eloyf26/PX4-Autopilot/hardware/cuav_v6x_fmum/photos/fmum_bottom_mcu_side.jpg

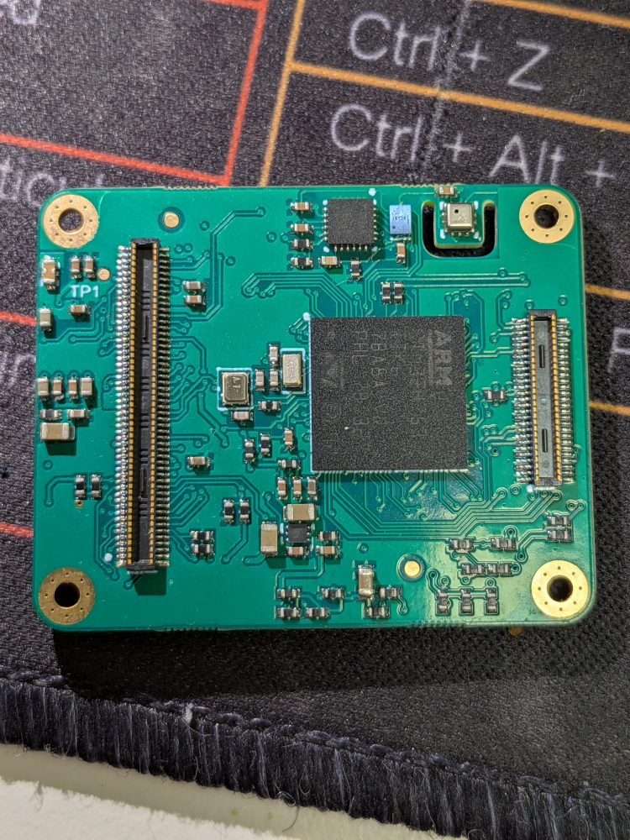
hardware/cuav_v6x_fmum/photos/fmum_bottom_mcu_side.jpg
