eloyf26/PX4-Autopilot/hardware/cuav_v6x_fmum/photos/imu_bottom_flex_side.jpg

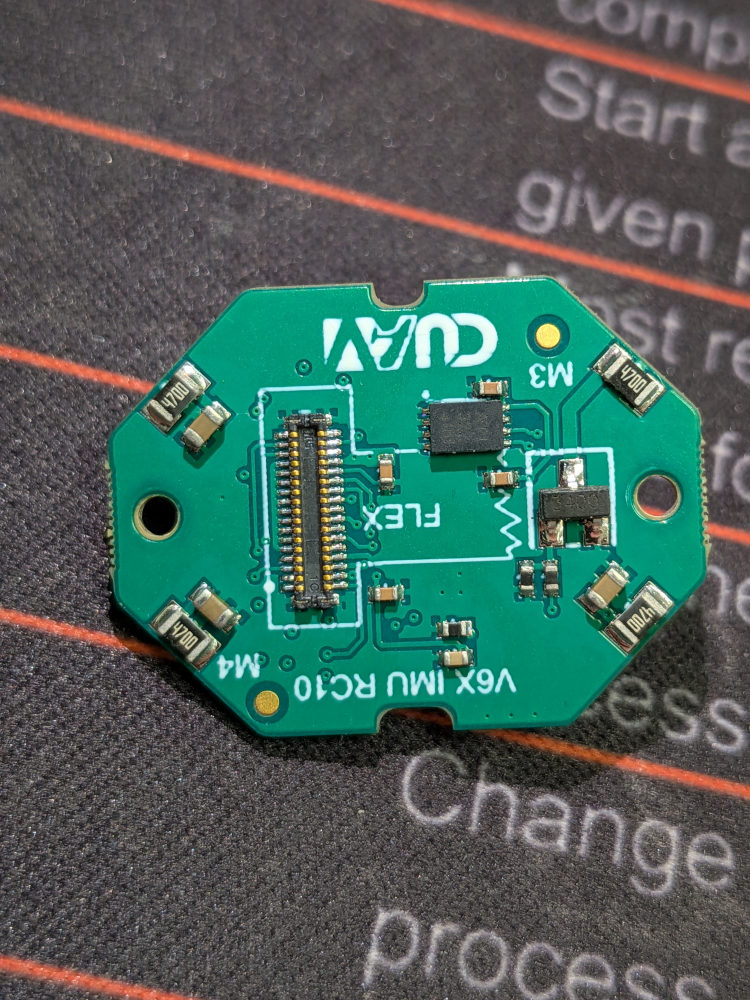
hardware/cuav_v6x_fmum/photos/imu_bottom_flex_side.jpg
