eloyf26/PX4-Autopilot/hardware/cuav_v6x_fmum/cuav_v6x_fmum_schematic.html

board identification · reverse-engineered schematic

# CUAV V6X FMUM — the plug-in brain of a Pixhawk V6X autopilot

Not official. CUAV publishes no schematic of the V6X modules and the full Pixhawk FMUv6X reference schematics are Dronecode-member-only. This is an independent reconstruction: connectivity from the PX4 firmware that runs on this hardware, connector pinouts from the public Pixhawk standards, part identification from the photos.

The board in your photos is the FMU core module of the CUAV Pixhawk V6X flight controller: an STM32H7 processor, memory, one IMU and one barometer on a 36 × 31 mm card that plugs into a base board through the Pixhawk Autopilot Bus. Below: what every visible part is, how the module works, and six schematic sheets rebuilt from the PX4 firmware that runs on it and the two public Pixhawk standards it implements.

silkscreen

V6X_FMUM RC11 · 07-17/23

maker

CUAV (Guangzhou)

standard

Pixhawk FMUv6X · PAB (DS-010 / DS-012)

processor

STM32H743IIK6, 480 MHz M7

firmware target

px4_fmu-v6x · HW type V6X001

size

36.0 × 31.4 mm · 4 × M2 ground holes

## 1 · What you are looking at

Bottom of the module (faces the base board): processor, both bus connectors, IMU 3, barometer 2, crystals, regulators.

U1 STM32H7 BGAX1 · 100-pin PABX2 · 50-pin PABICM-20649 IMU3ICP-20100 baro, in slotY1 16 MHz / Y2 32 kHz3.3 V step-downsensor LDOs + ID resistors

A Bottom of the module (faces the base board): processor, both bus connectors, IMU 3, barometer 2, crystals, regulators.

Top of the module (visible when installed): IMU flex connector, microSD, FRAM, secure element, RTC cell, LEDs, trace pads.

J3 FLEX → IMU boardJ4 microSDFM25V02A FRAMSE050 (likely)B1 RTC cellD1-D3 LEDsJ1 TRACE padsBT0 = BOOT0

B Top of the module (visible when installed): IMU flex connector, microSD, FRAM, secure element, RTC cell, LEDs, trace pads.

seen on the photo | what it is | confidence
10 × 10 mm BGA, marked ARM / STM32H7…IIK6 | U1, STM32H743IIK6 (PX4 configures the H753 sibling). UFBGA176+25. | HIGH
100-pin + 50-pin 0.4 mm connectors | X1 / X2 Hirose DF40 — the Pixhawk Autopilot Bus. 3 mm stack to the base board. | HIGH
3 × 3 mm QFN, top centre of MCU side | ICM-20649 six-axis IMU #3 on SPI1 (the one hard-mounted IMU). | HIGH
2 mm metal-lid part with a port hole, in a U-shaped routed slot | ICP-20100 barometer #2 on I2C2. The slot decouples it from board flex. | HIGH
Two small metal cans left of the BGA | Y1 16 MHz (HSE) and Y2 32.768 kHz (RTC) crystals — PX4 board.h confirms both frequencies. | HIGH
QFN + big inductor + capacitors, bottom centre | U_REG, the 5 V → 3.3 V step-down for the MCU rail. | MEDIUM
SOT-23-5 ICs with 0402 capacitor clusters, right edge | the four switched sensor LDOs and decoupling. | MEDIUM
1.5 mm blue part marked IY2K | small passive or IC (ESD array / tiny LDO). Not resolvable from the photo. | LOW
34-pin connector labelled FLEX | J3 to the separate vibration-isolated IMU board; two of the three IMUs and the compass are there. | HIGH
SOIC-8 at top | FM25V02A 256 kbit FRAM — PX4 parameter storage; byte-writable, no wear. | HIGH
3 × 3 mm QFN marked S50 08 07 | most likely NXP SE050 secure element (I2C4 0x48, in the reference sensor set). | MEDIUM
Round metal can marked L03 | B1 RTC backup cell; exported to the base as V_RTC_BAT (X1-29). | HIGH
Three 0603 LEDs, 8+2 unpopulated pads, BT0 pad | D1-D3 status LEDs · J1 ETM trace footprint · BOOT0 for the ST DFU bootloader. | HIGH

Where the confidence comes from. The module runs PX4's px4_fmu-v6x target and identifies itself as hardware type V6X001 ("CUAV sensor set rev 1") through a resistor ladder. The PX4 board files for that target hard-code every MCU pin, SPI chip-select, data-ready line, I²C address and power-enable, so the connectivity below is read from the firmware rather than guessed from traces. Connector pinouts come from the Pixhawk DS-010 and DS-012 standards. Only regulator part numbers, passive values and two small ICs are inferred.

### The second board: V6X IMU RC10

The octagonal board on the other end of the FLEX cable is CUAV's IMU board (silkscreen V6X IMU RC10, 2022-09-20). It sits in an elastomer isolation mount — the two half-round notches and the four ground pads M1-M4 are the mount interface — so the inertial sensors ride on a damped mass while the processor board is bolted rigidly to the base. It has no regulators: every rail arrives over the flex.

IMU board, sensor side: BMI088, ICM-42688-P, the RM3100 compass as controller plus three coils, barometer #1.

BMI088 (IMU 1)ICM-42688-P (IMU 2)PNI MagI2C (RM3100)Sen-XY-f coil XSen-XY-f coil YSen-Z-f coilICP-20100 baro #1flight arrow

C IMU board, sensor side: BMI088, ICM-42688-P, the RM3100 compass as controller plus three coils, barometer #1.

IMU board, flex side: mating 34-pin connector, calibration EEPROM, four 470 Ω heater resistors and their MOSFET.

FLEX (mates FMUM J3)24LC64 cal EEPROMMOSFET '3400'470 Ω heater ×4

D IMU board, flex side: mating 34-pin connector, calibration EEPROM, four 470 Ω heater resistors and their MOSFET.

seen on the photo | what it is | confidence
Rectangular LGA, top left (sensor side) | Bosch BMI088 accel + gyro — IMU 1 on SPI3, power domain 3. | HIGH
Small LGA below it | TDK ICM-42688-P — IMU 2 on SPI2, domain 2. | HIGH
4 × 4 mm QFN, centre right | PNI MagI2C, the controller of the RM3100 compass — I2C4 address 0x20. | HIGH
Two flat black bars marked PNI, one horizontal one vertical | PNI Sen-XY-f sense coils for the X and Y axes, mounted at 90°. | HIGH
Black cube below the QFN | PNI Sen-Z-f coil for the vertical axis. | HIGH
Metal lid with port hole, bottom left | TDK ICP-20100 barometer #1 — I2C4 address 0x64 (AD0 high). | HIGH
34-pin 0.4 mm connector labelled FLEX (flex side) | Mating half of the FMUM's J3; a short FPC jumper links the two boards. | HIGH
SOIC-8 (flex side) | 24LC64 calibration EEPROM — I2C4 0x50; PX4 stores calibration, revision and ID here. | HIGH
Four large resistors marked 4700 | 470 Ω heater resistors in parallel: 117 Ω across 5 V, about 0.21 W under the IMUs. | HIGH
SOT-23 marked 3400 beside a resistor silkscreen symbol | N-channel MOSFET (AO3400 class): low-side switch for the heater, driven by the HEATER line (PB10). | HIGH

## 2 · How the module works

Three boards, one system. Only 5 V and 3.3 V logic cross the connectors; everything that touches the outside world (transceivers, power switching, ESD) stays on the base board, which is what makes the module small and reusable across vendors.

#### base board (not this PCB)

Power path selector2 bricks + USB → VDD_5V_IN, 4 pins on X1

JST-GH portsTELEM1-3, GPS1/2, UART4, CAN1/2, USB, PWM, ADIO, debug

STM32F103 PX4IO8 more PWM + RC in, talks to U1 on USART6

LAN8742A Ethernet PHYRMII over X2

Base ID ladder + 24LC64 EEPROMHW_VER_SENSE, I2C3

X1 100 p
X2 50 p
⇄

#### FMU module — this board

U1 STM32H743IIK6480 MHz M7 · 2 MB flash · 1 MB RAM

U_REG 5 V → 3.3 V step-downFMU_VDD_3V3, also exported on X1-84/86

U_LDO1…4 switched 3.3 Vone per sensor domain · EN + ADC sense each

FM25V02A FRAM · SPI5parameters

microSD · SDMMC2logs · power-cycled by PC13

ICM-20649 · SPI1IMU 3, domain 1

ICP-20100 · I2C2baro 2, in stress-relief slot

SE050 · I2C4secure element (likely)

B1 RTC cell · Y1 16 MHz · Y2 32 kHztime-keeping

HW-ID ladder 24.9k/442kmodule ID 1 = CUAV sensor set rev 1

J3 34 p
⇄

#### IMU board (via J3 flex)

BMI088 · SPI3IMU 1, domain 3

ICM-42688-P · SPI2IMU 2, domain 2

RM3100 · I2C4 0x20compass, domain 4

ICP-20100 · I2C4 0x64baro 1, domain 4

24LC64 · I2C4 0x50calibration EEPROM

Heater resistors + MOSFETHEATER from PB10, VDD_5V_IN

- One supply in, everything generated locally. VDD_5V_IN enters on four X1 pins. A step-down makes FMU_VDD_3V3 for the MCU and memories; that rail is also exported back to the base (X1-84/86).
- Four independent sensor power domains. Each IMU or compass group has its own LDO with an MCU-controlled enable and a 1:2 divider read by the ADC, so PX4 can power-cycle one misbehaving domain and watch every rail.
- One IMU per SPI bus (SPI1/2/3), each with a hardware data-ready interrupt; a hung device cannot stall the others. I2C4 is the internal sensor bus, I2C1-3 go to the base for GPS pucks and power monitors.
- Storage: FRAM for parameters (byte-writable, no wear), microSD for logs, battery-backed RTC and SRAM.
- Self-identification. At boot PG0 powers two resistor ladders; ADC3 reads them on PH4 (module ID) and PH3 (base ID, via X1-27). PX4 then starts exactly the right drivers and axis rotations for this sensor set.

### Sensor set of this revision

role | part | bus | CS / addr | DRDY | power domain | location
IMU 1 | Bosch BMI088 accel + gyro | SPI3 | PI4 (accel) / PI8 (gyro) | PI7 | SENSORS3 | IMU board (J3)
IMU 2 | TDK ICM-42688-P | SPI2 | PH5 | PA10 | SENSORS2 | IMU board (J3)
IMU 3 | TDK ICM-20649 | SPI1 | PI9 | PF2 | SENSORS1 | this module
Compass | PNI RM3100 | I2C4 | 0x20 | — | SENSORS4 | IMU board (J3)
Baro 1 | TDK ICP-20100 | I2C4 | 0x64 | — | SENSORS4 | IMU board (J3)
Baro 2 | TDK ICP-20100 | I2C2 | 0x63 | PG5 | SENSORS2 | this module
Cal. EEPROM | 24LC64 | I2C4 | 0x50 | — | SENSORS4 | IMU board (J3)
Parameters | FM25V02A FRAM 256 kbit | SPI5 | PG7 | — | FMU 3V3 | this module
Secure element | NXP SE050 (likely) | I2C4 | 0x48 | — | FMU 3V3 | this module

## 3 · Schematic sheets

KiCad: two projects with PCBs. The same data is generated as two KiCad 8 projects in hardware/cuav_v6x_fmum/kicad/ on branch claude/unknown-component-schematics-mdgis0: fmum/cuav_v6x_fmum.kicad_pro (FMU module, 4 schematic sheets + a 36 × 31.4 mm 6-layer PCB) and imu/cuav_v6x_imu.kicad_pro (IMU board, schematic + 25 × 18 mm 4-layer PCB). Both boards carry the real outline, holes, connector positions from the Pixhawk standard, datasheet-verified footprints with every pad net-assigned, and photo-derived component placement. They are unrouted: the original inner-layer copper cannot be recovered from photos. The README lists exactly which footprint geometries were approximated.

Net names follow the Pixhawk standards, so they line up with the published base-board reference schematics. Blue = MCU pin, green = signal net, copper = power rail, grey = ground.

### Sheet 1 · U1 microcontroller

open full size ↗

Every used pin of the STM32H7: peripheral function inside the symbol, net name outside, and where the net goes in the margin. Pins not shown are unconnected on the module.

### Sheet 2 · Core peripherals

open full size ↗

FRAM, secure element, microSD with its power switch, both crystals, RTC cell, status LEDs, USB lines, the hardware-ID ladder and the reset / boot / trace provisions.

### Sheet 3 · Power domains and on-module sensors

open full size ↗

The 3.3 V step-down, the four switched sensor LDOs with their ADC dividers, the on-board ICM-20649 and ICP-20100, the heater control line and the I²C pull-ups.

### Sheet 4 · X1 — Pixhawk Autopilot Bus, 100 pins

open full size ↗

Pin-by-pin with the MCU pin that drives each signal. Odd pins on one row, even on the other.

### Sheet 5 · X2 — Pixhawk Autopilot Bus, 50 pins

open full size ↗

RMII Ethernet to the PHY on the base, the external SPI6 payload bus, and the pins the standard reserves but an FMUv6X module leaves unconnected.

### Sheet 6 · J3 — IMU flex connector, 34 pins

open full size ↗

Two SPI buses, I2C4, three switched 3.3 V rails, raw 5 V for the heater and the heater control line, with a ground between every signal group.

### Sheet 7 · IMU board (V6X IMU RC10)

open full size ↗

Everything on the vibration-isolated board: the mating flex connector, BMI088, ICM-42688-P, the RM3100 controller with its three coils, barometer #1, the calibration EEPROM and the heater with its MOSFET.

## 4 · Pin tables

### U1 pin map (as configured by PX4 for this module)

U1 pin | function | net | goes to
PA0 | ADC1_INP16 | SCALED_VDD_3V3_SENSORS1 | R-divider on VDD_3V3_SENSORS1
PA1 | ETH_REF_CLK | ETH_REF_CLK | X2-3
PA2 | ETH_MDIO | ETH_MDIO | X2-2
PA3 | USART2_RX | USART2_RX_TELEM3 | X1-42
PA4 | ADC12_INP18 | SCALED_VDD_3V3_SENSORS2 | R-divider on VDD_3V3_SENSORS2
PA5 | SPI1_SCK | SPI1_SCK_SENSOR1 | U_IMU3 ICM-20649 SCLK
PA6 | SPI6_MISO | SPI6_MISO_EXTERNAL1 | X2-31
PA7 | ETH_CRS_DV | ETH_CRS_DV | X2-7
PA8 | I2C3_SCL | I2C3_SCL_BASE | X1-10
PA9 | OTG_FS_VBUS | VBUS_SENSE | X1-80
PA10 | GPIO in (EXTI) | SPI2_DRDY2_IMU2_INT2 | J3-31
PA11 | OTG_FS_DM | USB_D_N | X1-78
PA12 | OTG_FS_DP | USB_D_P | X1-76
PA13 | SWDIO | FMU_SWDIO | X1-75
PA14 | SWCLK | FMU_SWCLK | X1-77
PA15 | GPIO out | SPI6_nCS2_EXTERNAL1 | X2-43
PB0 | ADC12_INP9 | SCALED_VDD_3V3_SENSORS3 | R-divider on VDD_3V3_SENSORS3
PB1 | ADC12_INP5 | SCALED_V5 | R-divider on VDD_5V_IN
PB2 | SPI3_MOSI | SPI3_MOSI_SENSOR3 | J3-14
PB3 | SPI6_SCK / SWO | SPI6_SCK_EXTERNAL1 | X2-35
PB4 | SDMMC2_D3 | SD_D3 | J4 microSD DAT3
PB5 | SPI1_MOSI | SPI1_MOSI_SENSOR1 | U_IMU3 ICM-20649 SDI
PB6 | USART1_TX | USART1_TX_GPS1 | X1-36
PB7 | USART1_RX | USART1_RX_GPS1 | X1-34
PB8 | I2C1_SCL | I2C1_SCL_BASE | X1-18
PB9 | I2C1_SDA | I2C1_SDA_BASE | X1-16
PB10 | GPIO out (TIM2_CH3) | HEATER | J3-30
PB11 | ETH_TX_EN | ETH_TX_EN | X2-27
PB12 | FDCAN2_RX | CAN2_RX | X1-59
PB13 | FDCAN2_TX | CAN2_TX | X1-57
PB14 | SDMMC2_D0 | SD_D0 | J4 microSD DAT0
PB15 | SDMMC2_D1 | SD_D1 | J4 microSD DAT1
PC0 | GPIO in (EXTI) | NFC_GPIO | X2-48
PC1 | ETH_MDC | ETH_MDC | X2-4
PC2 | ADC3_INP12 (PC2_C) | ADC1_6V6 | X1-90
PC3 | ADC3_INP13 (PC3_C) | ADC1_3V3 | X1-92
PC4 | ETH_RXD0 | ETH_RXD0 | X2-11
PC5 | ETH_RXD1 | ETH_RXD1 | X2-15
PC6 | USART6_TX | USART6_TX_TO_IO | X1-72
PC7 | USART6_RX | USART6_RX_FROM_IO_RC | X1-70
PC8 | UART5_RTS | UART5_RTS_TELEM2 | X1-58
PC9 | UART5_CTS | UART5_CTS_TELEM2 | X1-60
PC10 | SPI3_SCK | SPI3_SCK_SENSOR3 | J3-10
PC11 | SPI3_MISO | SPI3_MISO_SENSOR3 | J3-12
PC12 | UART5_TX | UART5_TX_TELEM2 | X1-52
PC13 | GPIO out | VDD_3V3_SD_CARD_EN | Q_SD load switch EN
PC14 | OSC32_IN | 32KHZ_IN | Y2 32.768 kHz
PC15 | OSC32_OUT | 32KHZ_OUT | Y2 32.768 kHz
PD0 | FDCAN1_RX | CAN1_RX | X1-65
PD1 | FDCAN1_TX | CAN1_TX | X1-63
PD2 | UART5_RX | UART5_RX_TELEM2 | X1-54
PD3 | USART2_CTS | USART2_CTS_TELEM3 | X1-48
PD4 | USART2_RTS | USART2_RTS_TELEM3 | X1-46
PD5 | USART2_TX | USART2_TX_TELEM3 | X1-40
PD6 | SDMMC2_CK | SD_CLK | J4 microSD CLK
PD7 | SDMMC2_CMD | SD_CMD | J4 microSD CMD
PD8 | USART3_TX | USART3_TX_DEBUG | X1-69
PD9 | USART3_RX | USART3_RX_DEBUG | X1-71
PD10 | GPIO out | FMU_nSAFETY_SWITCH_LED_OUT | X1-23
PD11 | GPIO in | SPI6_DRDY1_EXTERNAL1 | X2-47
PD12 | GPIO in | SPI6_DRDY2_EXTERNAL1 | X2-45
PD13 | TIM4_CH2 | FMU_CH5 | X1-7
PD14 | TIM4_CH3 | FMU_CH6 | X1-5
PD15 | GPIO in (spare) | PD15_SPARE | NC
PE0 | UART8_RX | UART8_RX_GPS2 | X1-30
PE1 | UART8_TX | UART8_TX_GPS2 | X1-28
PE2 | TRACECLK | TRACECLK | J1 TRACE-1
PE3 | GPIO od (TRACED0) | nLED_RED | D1 red LED cathode (+ J1 TRACE-3)
PE4 | GPIO od (TRACED1) | nLED_GREEN | D2 green LED cathode (+ J1 TRACE-5)
PE5 | GPIO od (TRACED2) | nLED_BLUE | D3 blue LED cathode (+ J1 TRACE-7)
PE6 | GPIO (TRACED3) | nARMED | X1-85 (+ J1 TRACE-8)
PE7 | GPIO out | VDD_3V3_SENSORS3_EN | U_LDO3 EN
PE8 | UART7_TX | UART7_TX_TELEM1 | X1-64
PE9 | GPIO out | SPIX_SYNC | X2-49
PE10 | UART7_CTS | UART7_CTS_TELEM1 | X1-24
PE11 | TIM1_CH2 (capture) | FMU_CAP1 | X1-97
PE15 | GPIO in | VDD_5V_PERIPH_nOC | X1-37
PF0 | I2C2_SDA | I2C2_SDA_BASE | X1-12 (+ U_BARO2 ICP-20100 SDA)
PF1 | I2C2_SCL | I2C2_SCL_BASE | X1-14 (+ U_BARO2 ICP-20100 SCL)
PF2 | GPIO in (EXTI) | SPI1_DRDY1_IMU3_INT1 | U_IMU3 ICM-20649 INT1
PF4 | GPIO out | VDD_3V3_SENSORS2_EN | U_LDO2 EN
PF5 | GPIO in (pull-up) | FMU_SAFETY_SWITCH_IN | X1-21
PF6 | UART7_RX | UART7_RX_TELEM1 | X1-66
PF7 | SPI5_SCK | SPI5_SCK_FRAM | U_FRAM FM25V02A SCK
PF8 | UART7_RTS | UART7_RTS_TELEM1 | X1-22
PF9 | TIM14_CH1 | BUZZER_1 | X1-4
PF10 | GPIO out | SPI6_nRESET_EXTERNAL1 | X2-39
PF11 | SPI5_MOSI | SPI5_MOSI_FRAM | U_FRAM FM25V02A SI
PF12 | ADC1_INP6 | SCALED_VDD_3V3_SENSORS4 | R-divider on VDD_3V3_SENSORS4
PF13 | GPIO in | VDD_5V_HIPOWER_nOC | X1-83
PF14 | I2C4_SCL | I2C4_SCL_FMU | J3-7 (+ U_SE SE050 SCL)
PF15 | I2C4_SDA | I2C4_SDA_FMU | J3-5 (+ U_SE SE050 SDA)
PG0 | GPIO out | HW_VER_REV_DRIVE | X1-25 (+ top of FMUM ID ladder)
PG1 | GPIO in (pull-up) | nPOWER_IN_A | X1-89
PG2 | GPIO in (pull-up) | nPOWER_IN_B | X1-91
PG3 | GPIO in (pull-up) | nPOWER_IN_C | X1-93
PG4 | GPIO out | VDD_5V_PERIPH_nEN | X1-35
PG5 | GPIO in (EXTI) | I2C2_DRDY1_BARO2 | U_BARO2 ICP-20100 INT (optional)
PG6 | GPIO in (pull-up) | PG6 | X2-44
PG7 | GPIO out | SPI5_nCS1_FRAM | U_FRAM FM25V02A nCS
PG8 | GPIO out | VDD_3V3_SENSORS4_EN | U_LDO4 EN
PG9 | SPI1_MISO | SPI1_MISO_SENSOR1 | U_IMU3 ICM-20649 SDO
PG10 | GPIO out | VDD_5V_HIPOWER_nEN | X1-81
PG11 | SDMMC2_D2 | SD_D2 | J4 microSD DAT2
PG12 | ETH_TXD1 | ETH_TXD1 | X2-23
PG13 | ETH_TXD0 | ETH_TXD0 | X2-19
PG14 | SPI6_MOSI | SPI6_MOSI_EXTERNAL1 | X2-33
PG15 | GPIO out | ETH_POWER_EN | X2-6
PH0 | OSC_IN | 16MHZ_IN | Y1 16 MHz
PH1 | OSC_OUT | 16MHZ_OUT | Y1 16 MHz
PH2 | GPIO out | VDD_3V3_SPEKTRUM_POWER_EN | X1-33
PH3 | ADC3_INP14 | HW_VER_SENSE | X1-27 (base-board ID ladder)
PH4 | ADC3_INP15 | HW_REV_SENSE | FMUM ID ladder (R_up 24.9k / R_dn 442k = ID 1)
PH5 | GPIO out | SPI2_nCS1_IMU2 | J3-33
PH6 | TIM12_CH1 | FMU_CH7 | X1-3
PH7 | SPI5_MISO | SPI5_MISO_FRAM | U_FRAM FM25V02A SO
PH8 | I2C3_SDA | I2C3_SDA_BASE | X1-8
PH9 | TIM12_CH2 | FMU_CH8 | X1-1
PH10 | TIM5_CH1 | FMU_CH4 | X1-11
PH11 | TIM5_CH2 | FMU_CH3 | X1-13 (+ X2-50 'PH11')
PH12 | TIM5_CH3 | FMU_CH2 | X1-15
PH13 | UART4_TX | UART4_TX | X1-98
PH14 | UART4_RX | UART4_RX | X1-96
PI0 | TIM5_CH4 | FMU_CH1 | X1-17
PI1 | SPI2_SCK | SPI2_SCK_SENSOR2 | J3-20
PI2 | SPI2_MISO | SPI2_MISO_SENSOR2 | J3-22
PI3 | SPI2_MOSI | SPI2_MOSI_SENSOR2 | J3-24
PI4 | GPIO out | SPI3_nCS1_BMI088_ACCEL | J3-2
PI5 | TIM8_CH1 (capture) | FMU_PPM_INPUT | X1-39
PI6 | GPIO in | SPI3_DRDY1_BMI088_INT1 | NC (not wired on flex for sensor set 1)
PI7 | GPIO in (EXTI) | SPI3_DRDY2_BMI088_INT3_GYRO | J3-3
PI8 | GPIO out | SPI3_nCS2_BMI088_GYRO | J3-4
PI9 | GPIO out | SPI1_nCS1_IMU3 | U_IMU3 ICM-20649 nCS
PI10 | GPIO out | SPI6_nCS1_EXTERNAL1 | X2-41
PI11 | GPIO out | VDD_3V3_SENSORS1_EN | U_LDO1 EN
NRST | reset | FMU_nRST | X1-87 (+ 100 nF to GND)
BOOT0 | boot select | BOOT0 | test pad 'BT0', 10k pull-down
VBAT | backup supply | V_RTC_BAT | B1 backup cell + X1-29
PDR_ON | power-down reset | FMU_VDD_3V3 | tie to VDD
VDD/VDDA/VDDUSB/VDDLDO | supply | FMU_VDD_3V3 | 100 nF per pin + 4.7 uF bulk
VCAP1/VCAP2 | core LDO caps | VCAP | 2.2 uF each to GND
VREF+ | ADC reference | FMU_VDD_3V3 | via ferrite/1 uF

### X1 — 100-pin bus

pin | net | U1 | pin | net | U1
1 | FMU_CH8 | PH9 | 2 | GND
3 | FMU_CH7 | PH6 | 4 | BUZZER_1 | PF9
5 | FMU_CH6 | PD14 | 6 | GND
7 | FMU_CH5 | PD13 | 8 | I2C3_SDA_BASE | PH8
9 | GND | | 10 | I2C3_SCL_BASE | PA8
11 | FMU_CH4 | PH10 | 12 | I2C2_SDA_BASE | PF0
13 | FMU_CH3 | PH11 | 14 | I2C2_SCL_BASE | PF1
15 | FMU_CH2 | PH12 | 16 | I2C1_SDA_BASE | PB9
17 | FMU_CH1 | PI0 | 18 | I2C1_SCL_BASE | PB8
19 | GND | | 20 | GND
21 | FMU_SAFETY_SWITCH_IN | PF5 | 22 | UART7_RTS_TELEM1 | PF8
23 | FMU_nSAFETY_SWITCH_LED_OUT | PD10 | 24 | UART7_CTS_TELEM1 | PE10
25 | HW_VER_REV_DRIVE | PG0 | 26 | GND
27 | HW_VER_SENSE | PH3 | 28 | UART8_TX_GPS2 | PE1
29 | V_RTC_BAT | | 30 | UART8_RX_GPS2 | PE0
31 | GND | | 32 | GND
33 | VDD_3V3_SPEKTRUM_POWER_EN | PH2 | 34 | USART1_RX_GPS1 | PB7
35 | VDD_5V_PERIPH_nEN | PG4 | 36 | USART1_TX_GPS1 | PB6
37 | VDD_5V_PERIPH_nOC | PE15 | 38 | GND
39 | FMU_PPM_INPUT | PI5 | 40 | USART2_TX_TELEM3 | PD5
41 | GND | | 42 | USART2_RX_TELEM3 | PA3
43 | GND | | 44 | GND
45 | GND | | 46 | USART2_RTS_TELEM3 | PD4
47 | GND | | 48 | USART2_CTS_TELEM3 | PD3
49 | VDD_5V_IN | | 50 | GND
51 | VDD_5V_IN | | 52 | UART5_TX_TELEM2 | PC12
53 | VDD_5V_IN | | 54 | UART5_RX_TELEM2 | PD2
55 | VDD_5V_IN | | 56 | GND
57 | CAN2_TX | PB13 | 58 | UART5_RTS_TELEM2 | PC8
59 | CAN2_RX | PB12 | 60 | UART5_CTS_TELEM2 | PC9
61 | GND | | 62 | GND
63 | CAN1_TX | PD1 | 64 | UART7_TX_TELEM1 | PE8
65 | CAN1_RX | PD0 | 66 | UART7_RX_TELEM1 | PF6
67 | GND | | 68 | GND
69 | USART3_TX_DEBUG | PD8 | 70 | USART6_RX_FROM_IO_RC | PC7
71 | USART3_RX_DEBUG | PD9 | 72 | USART6_TX_TO_IO | PC6
73 | GND | | 74 | GND
75 | FMU_SWDIO | PA13 | 76 | USB_D_P | PA12
77 | FMU_SWCLK | PA14 | 78 | USB_D_N | PA11
79 | GND | | 80 | VBUS_SENSE
81 | VDD_5V_HIPOWER_nEN | PG10 | 82 | GND
83 | VDD_5V_HIPOWER_nOC | PF13 | 84 | FMU_VDD_3V3
85 | nARMED | PE6 | 86 | FMU_VDD_3V3
87 | FMU_nRST | NRST | 88 | GND
89 | nPOWER_IN_A | PG1 | 90 | ADC1_6V6 | PC2
91 | nPOWER_IN_B | PG2 | 92 | ADC1_3V3 | PC3
93 | nPOWER_IN_C | PG3 | 94 | GND
95 | GND | | 96 | UART4_RX | PH14
97 | FMU_CAP1 | PE11 | 98 | UART4_TX | PH13
99 | GND | | 100 | GND

### X2 — 50-pin bus

pin | net | U1 | pin | net | U1
1 | GND | | 2 | ETH_MDIO | PA2
3 | ETH_REF_CLK | PA1 | 4 | ETH_MDC | PC1
5 | GND | | 6 | ETH_POWER_EN | PG15
7 | ETH_CRS_DV | PA7 | 8 | GND
9 | GND | | 10 | ETH_RX_ER n.c.
11 | ETH_RXD0 | PC4 | 12 | ETH_PHY_nINT n.c.
13 | GND | | 14 | GND
15 | ETH_RXD1 | PC5 | 16 | FMU_CH9 n.c.
17 | GND | | 18 | FMU_CH10 n.c.
19 | ETH_TXD0 | PG13 | 20 | FMU_CH11 n.c.
21 | GND | | 22 | FMU_CH12 n.c.
23 | ETH_TXD1 | PG12 | 24 | GND
25 | GND | | 26 | SPARE09 n.c.
27 | ETH_TX_EN | PB11 | 28 | SPARE10 n.c.
29 | GND | | 30 | SPARE11 n.c.
31 | SPI6_MISO_EXTERNAL1 | PA6 | 32 | SPARE12 n.c.
33 | SPI6_MOSI_EXTERNAL1 | PG14 | 34 | GND
35 | SPI6_SCK_EXTERNAL1 | PB3 | 36 | SPARE14 n.c.
37 | GND | | 38 | SPARE15 n.c.
39 | SPI6_nRESET_EXTERNAL1 | PF10 | 40 | CAN3_TX n.c.
41 | SPI6_nCS1_EXTERNAL1 | PI10 | 42 | CAN3_RX n.c.
43 | SPI6_nCS2_EXTERNAL1 | PA15 | 44 | PG6 | PG6
45 | SPI6_DRDY2_EXTERNAL1 | PD12 | 46 | GND
47 | SPI6_DRDY1_EXTERNAL1 | PD11 | 48 | NFC_GPIO | PC0
49 | SPIX_SYNC | PE9 | 50 | PH11 | PH11

### J3 — 34-pin IMU flex

pin | net | U1 | pin | net | U1
1 | GND | | 2 | SPI3_nCS1_BMI088_ACCEL | PI4
3 | SPI3_DRDY2_BMI088_INT3_GYRO | PI7 | 4 | SPI3_nCS2_BMI088_GYRO | PI8
5 | I2C4_SDA_FMU | PF15 | 6 | VDD_3V3_SENSORS3
7 | I2C4_SCL_FMU | PF14 | 8 | GND
9 | GND | | 10 | SPI3_SCK_SENSOR3 | PC10
11 | GND | | 12 | SPI3_MISO_SENSOR3 | PC11
13 | GND | | 14 | SPI3_MOSI_SENSOR3 | PB2
15 | GND | | 16 | VDD_3V3_SENSORS4
17 | GND | | 18 | GND
19 | GND | | 20 | SPI2_SCK_SENSOR2 | PI1
21 | GND | | 22 | SPI2_MISO_SENSOR2 | PI2
23 | GND | | 24 | SPI2_MOSI_SENSOR2 | PI3
25 | GND | | 26 | GND
27 | GND | | 28 | VDD_5V_IN
29 | GND | | 30 | HEATER | PB10
31 | SPI2_DRDY2_IMU2_INT2 | PA10 | 32 | VDD_3V3_SENSORS2
33 | SPI2_nCS1_IMU2 | PH5 | 34 | GND

### IMU board parts and nets

ref | part | package | pin = net
U1 | Bosch BMI088 (IMU 1) | LGA-16 3x4.5 | VDD=VDD_3V3_SENSORS3, VDDIO=VDD_3V3_SENSORS3, GND=GND, GNDIO=GND, PS=GND, SCK=SPI3_SCK_SENSOR3, SDI=SPI3_MOSI_SENSOR3, SDO1=SPI3_MISO_SENSOR3, SDO2=SPI3_MISO_SENSOR3, CSB1 (accel)=SPI3_nCS1_BMI088_ACCEL, CSB2 (gyro)=SPI3_nCS2_BMI088_GYRO, INT3 (gyro)=SPI3_DRDY2_BMI088_INT3_GYRO
U2 | TDK ICM-42688-P (IMU 2) | LGA-14 2.5x3 | VDD=VDD_3V3_SENSORS2, VDDIO=VDD_3V3_SENSORS2, GND=GND, SCLK=SPI2_SCK_SENSOR2, SDI=SPI2_MOSI_SENSOR2, SDO/AD0=SPI2_MISO_SENSOR2, nCS=SPI2_nCS1_IMU2, INT1=SPI2_DRDY2_IMU2_INT2
U3 | PNI MagI2C (RM3100 ASIC) | QFN 4x4 | VDD=VDD_3V3_SENSORS4, AVDD=VDD_3V3_SENSORS4, GND=GND, I2C_EN=VDD_3V3_SENSORS4, SA0=GND, SA1=GND, SCL=I2C4_SCL_FMU, SDA=I2C4_SDA_FMU, LX+=MAG_LX_A, LX-=MAG_LX_B, LY+=MAG_LY_A, LY-=MAG_LY_B, LZ+=MAG_LZ_A, LZ-=MAG_LZ_B
L1 | PNI Sen-XY-f coil, X | 6.5x2.5 | 1=MAG_LX_A, 2=MAG_LX_B
L2 | PNI Sen-XY-f coil, Y | 6.5x2.5 | 1=MAG_LY_A, 2=MAG_LY_B
L3 | PNI Sen-Z-f coil, Z | 3.6x3.6x3.2 | 1=MAG_LZ_A, 2=MAG_LZ_B
U4 | TDK ICP-20100 (baro 1) | LGA-10 2x2.5 | VDD=VDD_3V3_SENSORS4, VDDIO=VDD_3V3_SENSORS4, GND=GND, SCL=I2C4_SCL_FMU, SDA=I2C4_SDA_FMU, AD0=VDD_3V3_SENSORS4, CSB=VDD_3V3_SENSORS4
U5 | Microchip 24LC64 cal. EEPROM | SOIC-8 | VCC=VDD_3V3_SENSORS4, VSS=GND, A0=GND, A1=GND, A2=GND, WP=GND, SCL=I2C4_SCL_FMU, SDA=I2C4_SDA_FMU
Q1 | N-MOSFET, marked 3400 (AO3400 class) | SOT-23 | G=HEATER, D=HEATER_SW, S=GND
R1 | 470 R heater (marked 4700) | 1210 | 1=VDD_5V_IN, 2=HEATER_SW
R2 | 470 R heater (marked 4700) | 1210 | 1=VDD_5V_IN, 2=HEATER_SW
R3 | 470 R heater (marked 4700) | 1210 | 1=VDD_5V_IN, 2=HEATER_SW
R4 | 470 R heater (marked 4700) | 1210 | 1=VDD_5V_IN, 2=HEATER_SW
R5 | 100k gate pull-down | 0402 | 1=HEATER, 2=GND

## 5 · Parts list for a replica

ref | part | package | basis
U1 | STM32H743IIK6 / STM32H753IIK6 | UFBGA176+25 | ✔ from marking + PX4 defconfig
X1 | Hirose DF40C-100DP-0.4V(51) | 0.4 mm, 3 mm stack | ✔ DS-010; base side DF40HC(3.0)-100DS-0.4V(58)
X2 | Hirose DF40C-50DP-0.4V(51) | | ✔ DS-010; base side DF40HC(3.0)-50DS-0.4V(51)
J3 | Hirose BM20B(0.8)-34DP-0.4V(53) | 0.4 mm FPC receptacle | ✔ DS-012
J4 | Molex 5031821852 microSD push-push | | ✔ marking
U_FRAM | Infineon FM25V02A-G | SOIC-8 | ✔ PX4 mtd.cpp
U_SE | NXP SE050C1HQ1/Z01SC | HX2QFN-20 | likely; optional for PX4
U_IMU3 | TDK ICM-20649 | QFN-24 3×3 | ✔ PX4 rc.board_sensors V6X001
U_BARO2 | TDK ICP-20100 | LGA-10 2×2.5 | ✔ PX4 + photo (slot island)
U_REG | 3.3 V buck 1 A (e.g. TPS62A01 / TPS563201) | QFN/SOT + 2.2 µH | substitute
U_LDO1-4 | 3.3 V LDO 300 mA with EN (e.g. TLV75533PDBV) | SOT-23-5 | substitute; EN = PI11 / PF4 / PE7 / PG8
Q_SD | load switch (e.g. TPS22918) | SOT-23-6 | substitute; EN = PC13
Y1 | 16.000 MHz, CL 8-10 pF + 2×10 pF | 3225 | ✔ frequency
Y2 | 32.768 kHz, CL 6-7 pF + 2×6.8 pF | 3215 / 2012 | ✔ frequency
B1 | rechargeable Li cell 3 V (Seiko MS621FE) or 0.1 F supercap | | charge via BAT54 + 1 kΩ
D1-D3 | red / green / blue LED + 470 Ω-1 kΩ | 0603 | ✔
R-ID | 24.9 kΩ + 442 kΩ, 1 % | 0402 | ✔ module ID 1
R-pull | 1.5 kΩ ×8 on I2C1-4 | 0402 | ✔ DS-010 requirement
R-div | 10 kΩ ×10 (5 rails, 1:2) | 0402 | ✔ PX4 scaling
C | 100 nF ×~20, 2.2 µF ×2 (VCAP), 4.7-22 µF bulk | 0402/0603 | standard H7 decoupling
IMU U1 | Bosch BMI088 | LGA-16 3×4.5 | ✔ IMU board
IMU U2 | TDK ICM-42688-P | LGA-14 2.5×3 | ✔ IMU board
IMU U3 + L1-L3 | PNI RM3100 set: MagI2C + 2× Sen-XY-f + 1× Sen-Z-f | QFN 4×4 + coils | ✔ IMU board (PNI marking on coils)
IMU U4 | TDK ICP-20100 | LGA-10 2×2.5 | ✔ IMU board, AD0 high → 0x64
IMU U5 | Microchip 24LC64 | SOIC-8 | ✔ PX4 mtd.cpp
IMU Q1, R1-R4 | AO3400-class N-MOSFET + 4× 470 Ω (marked 4700) | SOT-23, 1210 | ✔ markings
IMU J1 | Hirose BM20B(0.8)-34DS-0.4V(53) + FPC jumper | 0.4 mm | mates FMUM J3

## 6 · Replicating it as a learning project

The original is a 6-layer, 0.4 mm-pitch BGA board — a poor first PCB. The electronics, however, split cleanly into stages that each produce a working board and reuse the pin tables above.

1. Same brain, big pins. STM32H743VIT6 (LQFP-100) or ZIT6 (LQFP-144) on a 2-layer board with FRAM, microSD, both crystals, LEDs, USB and an SWD header. Keep the pin functions from the table wherever the LQFP exposes them. Make your own PX4 board folder by copying boards/px4/fmu-v6x and editing board.h, board_config.h, spi.cpp, timer_config.cpp to your pins — the reverse of how these tables were produced.
2. One sensor domain. Add one LDO with enable, one IMU on SPI1 with its DRDY line (ICM-42688-P is easier to buy than ICM-20649), one barometer on I²C. Learn decoupling, the rail-sense divider, and how rc.board_sensors starts drivers.
3. The bus. Add the two DF40 connectors and a minimal base board (USB-C, 5 V in, one UART, buzzer, safety switch). Your module now fits any commercial Pixhawk Autopilot Bus base board — that is the real payoff of copying the standard.
4. Go BGA. Move to the IIK6 package and 6 layers once you can get X-ray-inspected assembly. Compare against the open-hardware Holybro Pixhawk 6X and ARK V6X modules, which publish full schematics.

### Things that bite

- BOOT0 needs a 10 k pull-down and a reachable pad — you will use DFU at least once.
- VCAP1/VCAP2 need low-ESR 2.2 µF right at the balls or the H7 will not start.
- SD power switching is not optional: PX4 power-cycles the card on error.
- I²C pull-ups belong on the module (DS-010) so a bare module never has floating buses.
- DRDY lines must be EXTI-capable pins as listed, or PX4 falls back to polling and IMU timing suffers.
- Ground generously through the DF40 GND pins and the four mounting holes; they return the 25 MHz SD and 50 MHz RMII currents.

## 7 · Sources

PX4-Autopilot, boards/px4/fmu-v6x/: nuttx-config/include/board.h (alternate-function pin map), src/board_config.h (GPIO, ADC, HW-ID, power control), src/spi.cpp (chip selects, DRDY, rail enables per hardware version), src/i2c.cpp, src/timer_config.cpp (PWM), src/mtd.cpp (FRAM/EEPROM), init/rc.board_sensors (drivers per hardware version, branch V6X001); platforms/common/pab_manifest.c; platforms/nuttx/src/px4/stm/stm32_common/board_hw_info/board_hw_rev_ver.c (ID ladder table).

Pixhawk SIG, DS-010 Pixhawk Autopilot Bus Standard (connector parts, X1/X2 pinouts, mechanics) and DS-012 Pixhawk Autopilot FMUv6X Standard (sensor sets, IMU flex pinout). PX4 user guide, CUAV Pixhawk V6X; CUAV, Pixhawk V6X Controller Product Manual (2023-11).

This is an independent reconstruction for study, not CUAV documentation. Where the DS-012 draft pinout sheet and the PX4 board files disagree, the PX4 files were taken as truth because this exact module boots them.
