eloyf26/PX4-Autopilot/hardware/cuav_v6x_fmum/photos/fmum_top_sd_side.jpg

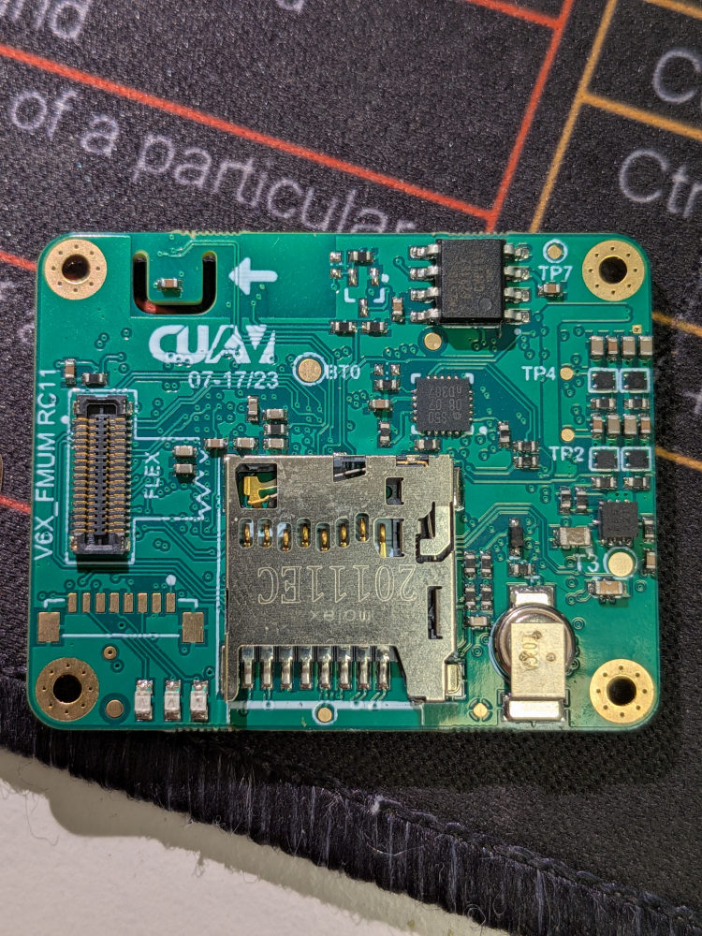
hardware/cuav_v6x_fmum/photos/fmum_top_sd_side.jpg
