eloyf26/PX4-Autopilot/hardware/cuav_v6x_fmum/photos/imu_top_sensor_side.jpg

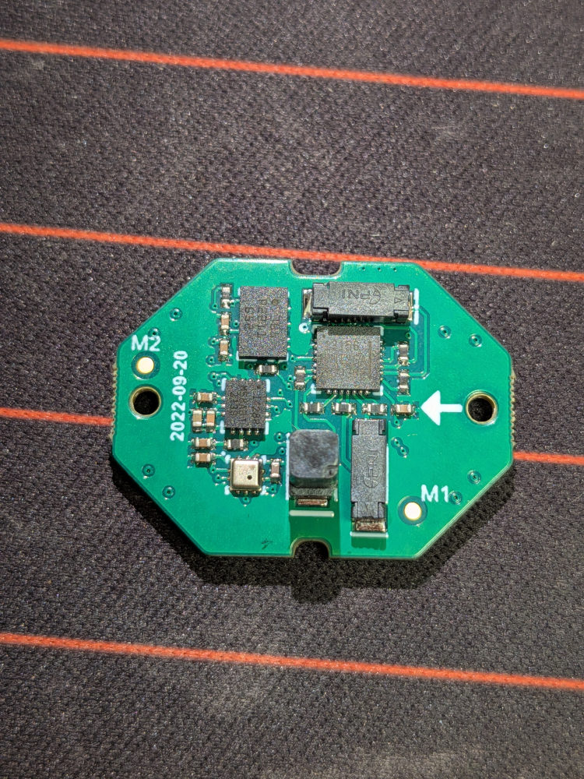
hardware/cuav_v6x_fmum/photos/imu_top_sensor_side.jpg
