eloyf26/PX4-Autopilot/hardware/cuav_v6x_fmum/kicad/fmum/cuav_v6x_fmum.kicad_pcb

## KiCad design hardware/cuav_v6x_fmum/kicad/fmum/cuav_v6x_fmum.kicad_pcb (2026-09-11)

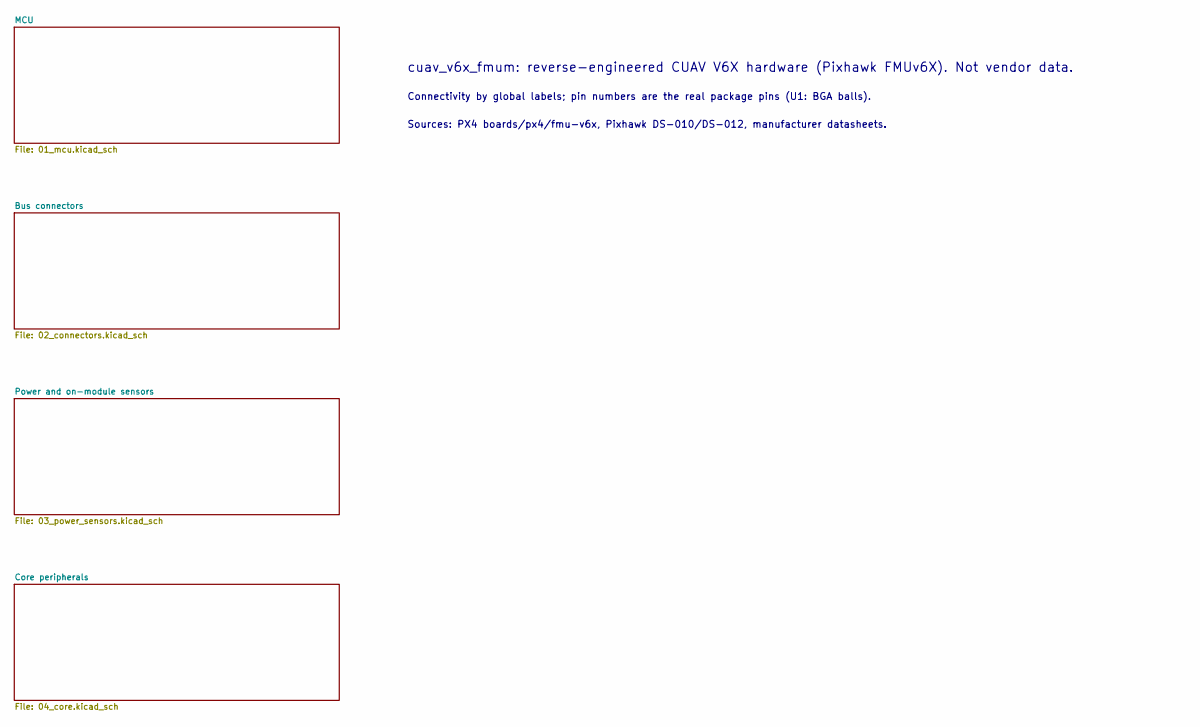
[picture p5: schematic cuav_v6x_fmum.kicad_sch]

Notes on the sheet:
cuav_v6x_fmum: reverse-engineered CUAV V6X hardware (Pixhawk FMUv6X). Not vendor data.
Connectivity by global labels; pin numbers are the real package pins (U1: BGA balls).
Sources: PX4 boards/px4/fmu-v6x, Pixhawk DS-010/DS-012, manufacturer datasheets.

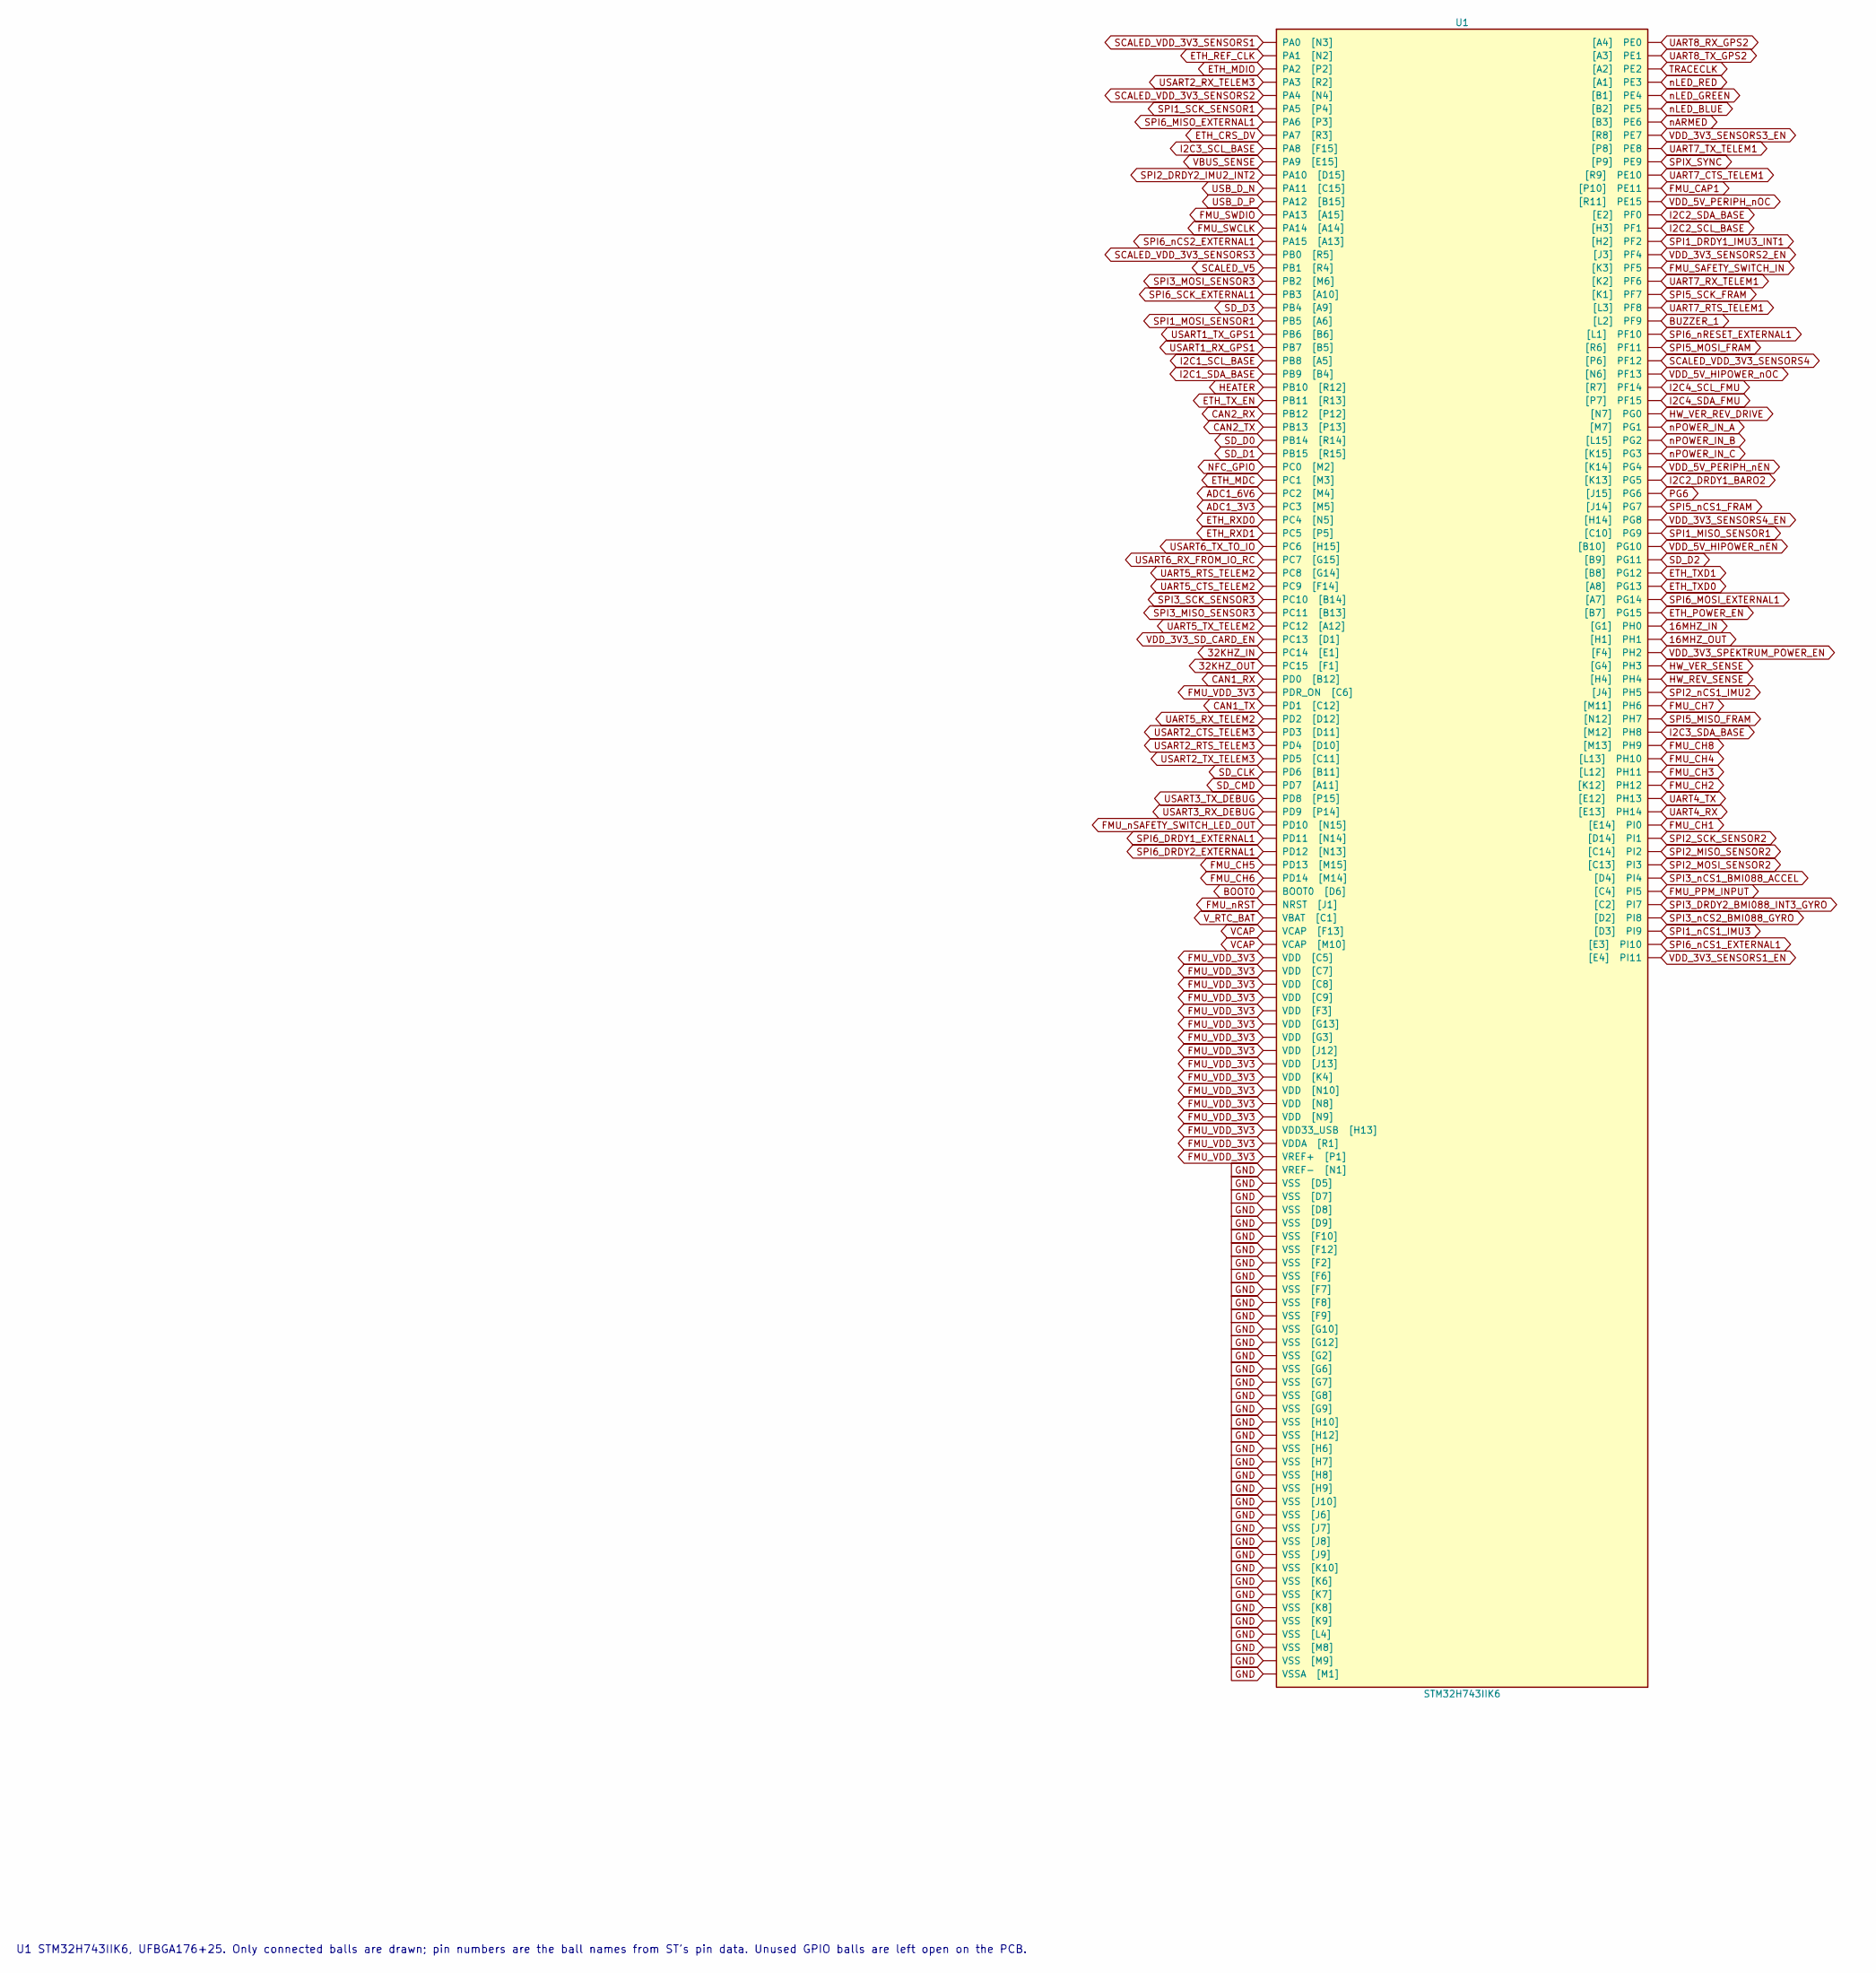
[picture p6: schematic 01_mcu.kicad_sch]

Parts:
U1: STM32H743IIK6; ST_UFBGA-176+25_10x10mm_Layout15x15_P0.65mm

Connections:
16MHZ_IN: U1.G1 ([G1] PH0); also elsewhere on the board
16MHZ_OUT: U1.H1 ([H1] PH1); also elsewhere on the board
32KHZ_IN: U1.E1 (PC14 [E1]); also elsewhere on the board
32KHZ_OUT: U1.F1 (PC15 [F1]); also elsewhere on the board
ADC1_3V3: U1.M5 (PC3 [M5]); also elsewhere on the board
ADC1_6V6: U1.M4 (PC2 [M4]); also elsewhere on the board
BOOT0: U1.D6 (BOOT0 [D6]); also elsewhere on the board
BUZZER_1: U1.L2 ([L2] PF9); also elsewhere on the board
CAN1_RX: U1.B12 (PD0 [B12]); also elsewhere on the board
CAN1_TX: U1.C12 (PD1 [C12]); also elsewhere on the board
CAN2_RX: U1.P12 (PB12 [P12]); also elsewhere on the board
CAN2_TX: U1.P13 (PB13 [P13]); also elsewhere on the board
ETH_CRS_DV: U1.R3 (PA7 [R3]); also elsewhere on the board
ETH_MDC: U1.M3 (PC1 [M3]); also elsewhere on the board
ETH_MDIO: U1.P2 (PA2 [P2]); also elsewhere on the board
ETH_POWER_EN: U1.B7 ([B7] PG15); also elsewhere on the board
ETH_REF_CLK: U1.N2 (PA1 [N2]); also elsewhere on the board
ETH_RXD0: U1.N5 (PC4 [N5]); also elsewhere on the board
ETH_RXD1: U1.P5 (PC5 [P5]); also elsewhere on the board
ETH_TXD0: U1.A8 ([A8] PG13); also elsewhere on the board
ETH_TXD1: U1.B8 ([B8] PG12); also elsewhere on the board
ETH_TX_EN: U1.R13 (PB11 [R13]); also elsewhere on the board
FMU_CAP1: U1.P10 ([P10] PE11); also elsewhere on the board
FMU_CH1: U1.E14 ([E14] PI0); also elsewhere on the board
FMU_CH2: U1.K12 ([K12] PH12); also elsewhere on the board
FMU_CH3: U1.L12 ([L12] PH11); also elsewhere on the board
FMU_CH4: U1.L13 ([L13] PH10); also elsewhere on the board
FMU_CH5: U1.M15 (PD13 [M15]); also elsewhere on the board
FMU_CH6: U1.M14 (PD14 [M14]); also elsewhere on the board
FMU_CH7: U1.M11 ([M11] PH6); also elsewhere on the board
FMU_CH8: U1.M13 ([M13] PH9); also elsewhere on the board
FMU_PPM_INPUT: U1.C4 ([C4] PI5); also elsewhere on the board
FMU_SAFETY_SWITCH_IN: U1.K3 ([K3] PF5); also elsewhere on the board
FMU_SWCLK: U1.A14 (PA14 [A14]); also elsewhere on the board
FMU_SWDIO: U1.A15 (PA13 [A15]); also elsewhere on the board
FMU_VDD_3V3: U1.C5 (VDD [C5]), U1.C6 (PDR_ON [C6]), U1.C7 (VDD [C7]), U1.C8 (VDD [C8]), U1.C9 (VDD [C9]), U1.F3 (VDD [F3]), U1.G3 (VDD [G3]), U1.G13 (VDD [G13]), U1.H13 (VDD33_USB [H13]), U1.J12 (VDD [J12]), U1.J13 (VDD [J13]), U1.K4 (VDD [K4]), U1.N8 (VDD [N8]), U1.N9 (VDD [N9]), U1.N10 (VDD [N10]), U1.P1 (VREF+ [P1]), U1.R1 (VDDA [R1]); also elsewhere on the board
FMU_nRST: U1.J1 (NRST [J1]); also elsewhere on the board
FMU_nSAFETY_SWITCH_LED_OUT: U1.N15 (PD10 [N15]); also elsewhere on the board
GND: U1.D5 (VSS [D5]), U1.D7 (VSS [D7]), U1.D8 (VSS [D8]), U1.D9 (VSS [D9]), U1.F2 (VSS [F2]), U1.F6 (VSS [F6]), U1.F7 (VSS [F7]), U1.F8 (VSS [F8]), U1.F9 (VSS [F9]), U1.F10 (VSS [F10]), U1.F12 (VSS [F12]), U1.G2 (VSS [G2]), U1.G6 (VSS [G6]), U1.G7 (VSS [G7]), U1.G8 (VSS [G8]), U1.G9 (VSS [G9]), U1.G10 (VSS [G10]), U1.G12 (VSS [G12]), U1.H6 (VSS [H6]), U1.H7 (VSS [H7]), U1.H8 (VSS [H8]), U1.H9 (VSS [H9]), U1.H10 (VSS [H10]), U1.H12 (VSS [H12]), U1.J6 (VSS [J6]), U1.J7 (VSS [J7]), U1.J8 (VSS [J8]), U1.J9 (VSS [J9]), U1.J10 (VSS [J10]), U1.K6 (VSS [K6]), U1.K7 (VSS [K7]), U1.K8 (VSS [K8]), U1.K9 (VSS [K9]), U1.K10 (VSS [K10]), U1.L4 (VSS [L4]), U1.M1 (VSSA [M1]), U1.M8 (VSS [M8]), U1.M9 (VSS [M9]), U1.N1 (VREF- [N1]); also elsewhere on the board
HEATER: U1.R12 (PB10 [R12]); also elsewhere on the board
HW_REV_SENSE: U1.H4 ([H4] PH4); also elsewhere on the board
HW_VER_REV_DRIVE: U1.N7 ([N7] PG0); also elsewhere on the board
HW_VER_SENSE: U1.G4 ([G4] PH3); also elsewhere on the board
I2C1_SCL_BASE: U1.A5 (PB8 [A5]); also elsewhere on the board
I2C1_SDA_BASE: U1.B4 (PB9 [B4]); also elsewhere on the board
I2C2_DRDY1_BARO2: U1.K13 ([K13] PG5); also elsewhere on the board
I2C2_SCL_BASE: U1.H3 ([H3] PF1); also elsewhere on the board
I2C2_SDA_BASE: U1.E2 ([E2] PF0); also elsewhere on the board
I2C3_SCL_BASE: U1.F15 (PA8 [F15]); also elsewhere on the board
I2C3_SDA_BASE: U1.M12 ([M12] PH8); also elsewhere on the board
I2C4_SCL_FMU: U1.R7 ([R7] PF14); also elsewhere on the board
I2C4_SDA_FMU: U1.P7 ([P7] PF15); also elsewhere on the board
NFC_GPIO: U1.M2 (PC0 [M2]); also elsewhere on the board
PG6: U1.J15 ([J15] PG6); also elsewhere on the board
SCALED_V5: U1.R4 (PB1 [R4]); also elsewhere on the board
SCALED_VDD_3V3_SENSORS1: U1.N3 (PA0 [N3]); also elsewhere on the board
SCALED_VDD_3V3_SENSORS2: U1.N4 (PA4 [N4]); also elsewhere on the board
SCALED_VDD_3V3_SENSORS3: U1.R5 (PB0 [R5]); also elsewhere on the board
SCALED_VDD_3V3_SENSORS4: U1.P6 ([P6] PF12); also elsewhere on the board
SD_CLK: U1.B11 (PD6 [B11]); also elsewhere on the board
SD_CMD: U1.A11 (PD7 [A11]); also elsewhere on the board
SD_D0: U1.R14 (PB14 [R14]); also elsewhere on the board
SD_D1: U1.R15 (PB15 [R15]); also elsewhere on the board
SD_D2: U1.B9 ([B9] PG11); also elsewhere on the board
SD_D3: U1.A9 (PB4 [A9]); also elsewhere on the board
SPI1_DRDY1_IMU3_INT1: U1.H2 ([H2] PF2); also elsewhere on the board
SPI1_MISO_SENSOR1: U1.C10 ([C10] PG9); also elsewhere on the board
SPI1_MOSI_SENSOR1: U1.A6 (PB5 [A6]); also elsewhere on the board
SPI1_SCK_SENSOR1: U1.P4 (PA5 [P4]); also elsewhere on the board
SPI1_nCS1_IMU3: U1.D3 ([D3] PI9); also elsewhere on the board
SPI2_DRDY2_IMU2_INT2: U1.D15 (PA10 [D15]); also elsewhere on the board
SPI2_MISO_SENSOR2: U1.C14 ([C14] PI2); also elsewhere on the board
SPI2_MOSI_SENSOR2: U1.C13 ([C13] PI3); also elsewhere on the board
SPI2_SCK_SENSOR2: U1.D14 ([D14] PI1); also elsewhere on the board
SPI2_nCS1_IMU2: U1.J4 ([J4] PH5); also elsewhere on the board
SPI3_DRDY2_BMI088_INT3_GYRO: U1.C2 ([C2] PI7); also elsewhere on the board
SPI3_MISO_SENSOR3: U1.B13 (PC11 [B13]); also elsewhere on the board
SPI3_MOSI_SENSOR3: U1.M6 (PB2 [M6]); also elsewhere on the board
SPI3_SCK_SENSOR3: U1.B14 (PC10 [B14]); also elsewhere on the board
SPI3_nCS1_BMI088_ACCEL: U1.D4 ([D4] PI4); also elsewhere on the board
SPI3_nCS2_BMI088_GYRO: U1.D2 ([D2] PI8); also elsewhere on the board
SPI5_MISO_FRAM: U1.N12 ([N12] PH7); also elsewhere on the board
SPI5_MOSI_FRAM: U1.R6 ([R6] PF11); also elsewhere on the board
SPI5_SCK_FRAM: U1.K1 ([K1] PF7); also elsewhere on the board
SPI5_nCS1_FRAM: U1.J14 ([J14] PG7); also elsewhere on the board
SPI6_DRDY1_EXTERNAL1: U1.N14 (PD11 [N14]); also elsewhere on the board
SPI6_DRDY2_EXTERNAL1: U1.N13 (PD12 [N13]); also elsewhere on the board
SPI6_MISO_EXTERNAL1: U1.P3 (PA6 [P3]); also elsewhere on the board
SPI6_MOSI_EXTERNAL1: U1.A7 ([A7] PG14); also elsewhere on the board
SPI6_SCK_EXTERNAL1: U1.A10 (PB3 [A10]); also elsewhere on the board
SPI6_nCS1_EXTERNAL1: U1.E3 ([E3] PI10); also elsewhere on the board
SPI6_nCS2_EXTERNAL1: U1.A13 (PA15 [A13]); also elsewhere on the board
SPI6_nRESET_EXTERNAL1: U1.L1 ([L1] PF10); also elsewhere on the board
SPIX_SYNC: U1.P9 ([P9] PE9); also elsewhere on the board
TRACECLK: U1.A2 ([A2] PE2); also elsewhere on the board
UART4_RX: U1.E13 ([E13] PH14); also elsewhere on the board
UART4_TX: U1.E12 ([E12] PH13); also elsewhere on the board
UART5_CTS_TELEM2: U1.F14 (PC9 [F14]); also elsewhere on the board
UART5_RTS_TELEM2: U1.G14 (PC8 [G14]); also elsewhere on the board
UART5_RX_TELEM2: U1.D12 (PD2 [D12]); also elsewhere on the board
UART5_TX_TELEM2: U1.A12 (PC12 [A12]); also elsewhere on the board
UART7_CTS_TELEM1: U1.R9 ([R9] PE10); also elsewhere on the board
UART7_RTS_TELEM1: U1.L3 ([L3] PF8); also elsewhere on the board
UART7_RX_TELEM1: U1.K2 ([K2] PF6); also elsewhere on the board
UART7_TX_TELEM1: U1.P8 ([P8] PE8); also elsewhere on the board
UART8_RX_GPS2: U1.A4 ([A4] PE0); also elsewhere on the board
UART8_TX_GPS2: U1.A3 ([A3] PE1); also elsewhere on the board
USART1_RX_GPS1: U1.B5 (PB7 [B5]); also elsewhere on the board
USART1_TX_GPS1: U1.B6 (PB6 [B6]); also elsewhere on the board
USART2_CTS_TELEM3: U1.D11 (PD3 [D11]); also elsewhere on the board
USART2_RTS_TELEM3: U1.D10 (PD4 [D10]); also elsewhere on the board
USART2_RX_TELEM3: U1.R2 (PA3 [R2]); also elsewhere on the board
USART2_TX_TELEM3: U1.C11 (PD5 [C11]); also elsewhere on the board
USART3_RX_DEBUG: U1.P14 (PD9 [P14]); also elsewhere on the board
USART3_TX_DEBUG: U1.P15 (PD8 [P15]); also elsewhere on the board
USART6_RX_FROM_IO_RC: U1.G15 (PC7 [G15]); also elsewhere on the board
USART6_TX_TO_IO: U1.H15 (PC6 [H15]); also elsewhere on the board
USB_D_N: U1.C15 (PA11 [C15]); also elsewhere on the board
USB_D_P: U1.B15 (PA12 [B15]); also elsewhere on the board
VBUS_SENSE: U1.E15 (PA9 [E15]); also elsewhere on the board
VCAP: U1.F13 (VCAP [F13]), U1.M10 (VCAP [M10]); also elsewhere on the board
VDD_3V3_SD_CARD_EN: U1.D1 (PC13 [D1]); also elsewhere on the board
VDD_3V3_SENSORS1_EN: U1.E4 ([E4] PI11); also elsewhere on the board
VDD_3V3_SENSORS2_EN: U1.J3 ([J3] PF4); also elsewhere on the board
VDD_3V3_SENSORS3_EN: U1.R8 ([R8] PE7); also elsewhere on the board
VDD_3V3_SENSORS4_EN: U1.H14 ([H14] PG8); also elsewhere on the board
VDD_3V3_SPEKTRUM_POWER_EN: U1.F4 ([F4] PH2); also elsewhere on the board
VDD_5V_HIPOWER_nEN: U1.B10 ([B10] PG10); also elsewhere on the board
VDD_5V_HIPOWER_nOC: U1.N6 ([N6] PF13); also elsewhere on the board
VDD_5V_PERIPH_nEN: U1.K14 ([K14] PG4); also elsewhere on the board
VDD_5V_PERIPH_nOC: U1.R11 ([R11] PE15); also elsewhere on the board
V_RTC_BAT: U1.C1 (VBAT [C1]); also elsewhere on the board
nARMED: U1.B3 ([B3] PE6); also elsewhere on the board
nLED_BLUE: U1.B2 ([B2] PE5); also elsewhere on the board
nLED_GREEN: U1.B1 ([B1] PE4); also elsewhere on the board
nLED_RED: U1.A1 ([A1] PE3); also elsewhere on the board
nPOWER_IN_A: U1.M7 ([M7] PG1); also elsewhere on the board
nPOWER_IN_B: U1.L15 ([L15] PG2); also elsewhere on the board
nPOWER_IN_C: U1.K15 ([K15] PG3); also elsewhere on the board

Notes on the sheet:
U1 STM32H743IIK6, UFBGA176+25. Only connected balls are drawn; pin numbers are the ball names from ST's pin data. Unused GPIO balls are left open on the PCB.
