eloyf26/PX4-Autopilot/hardware/cuav_v6x_fmum/kicad/fmum/cuav_v6x_fmum.kicad_pcb

## KiCad design hardware/cuav_v6x_fmum/kicad/fmum/cuav_v6x_fmum.kicad_pcb (continued)

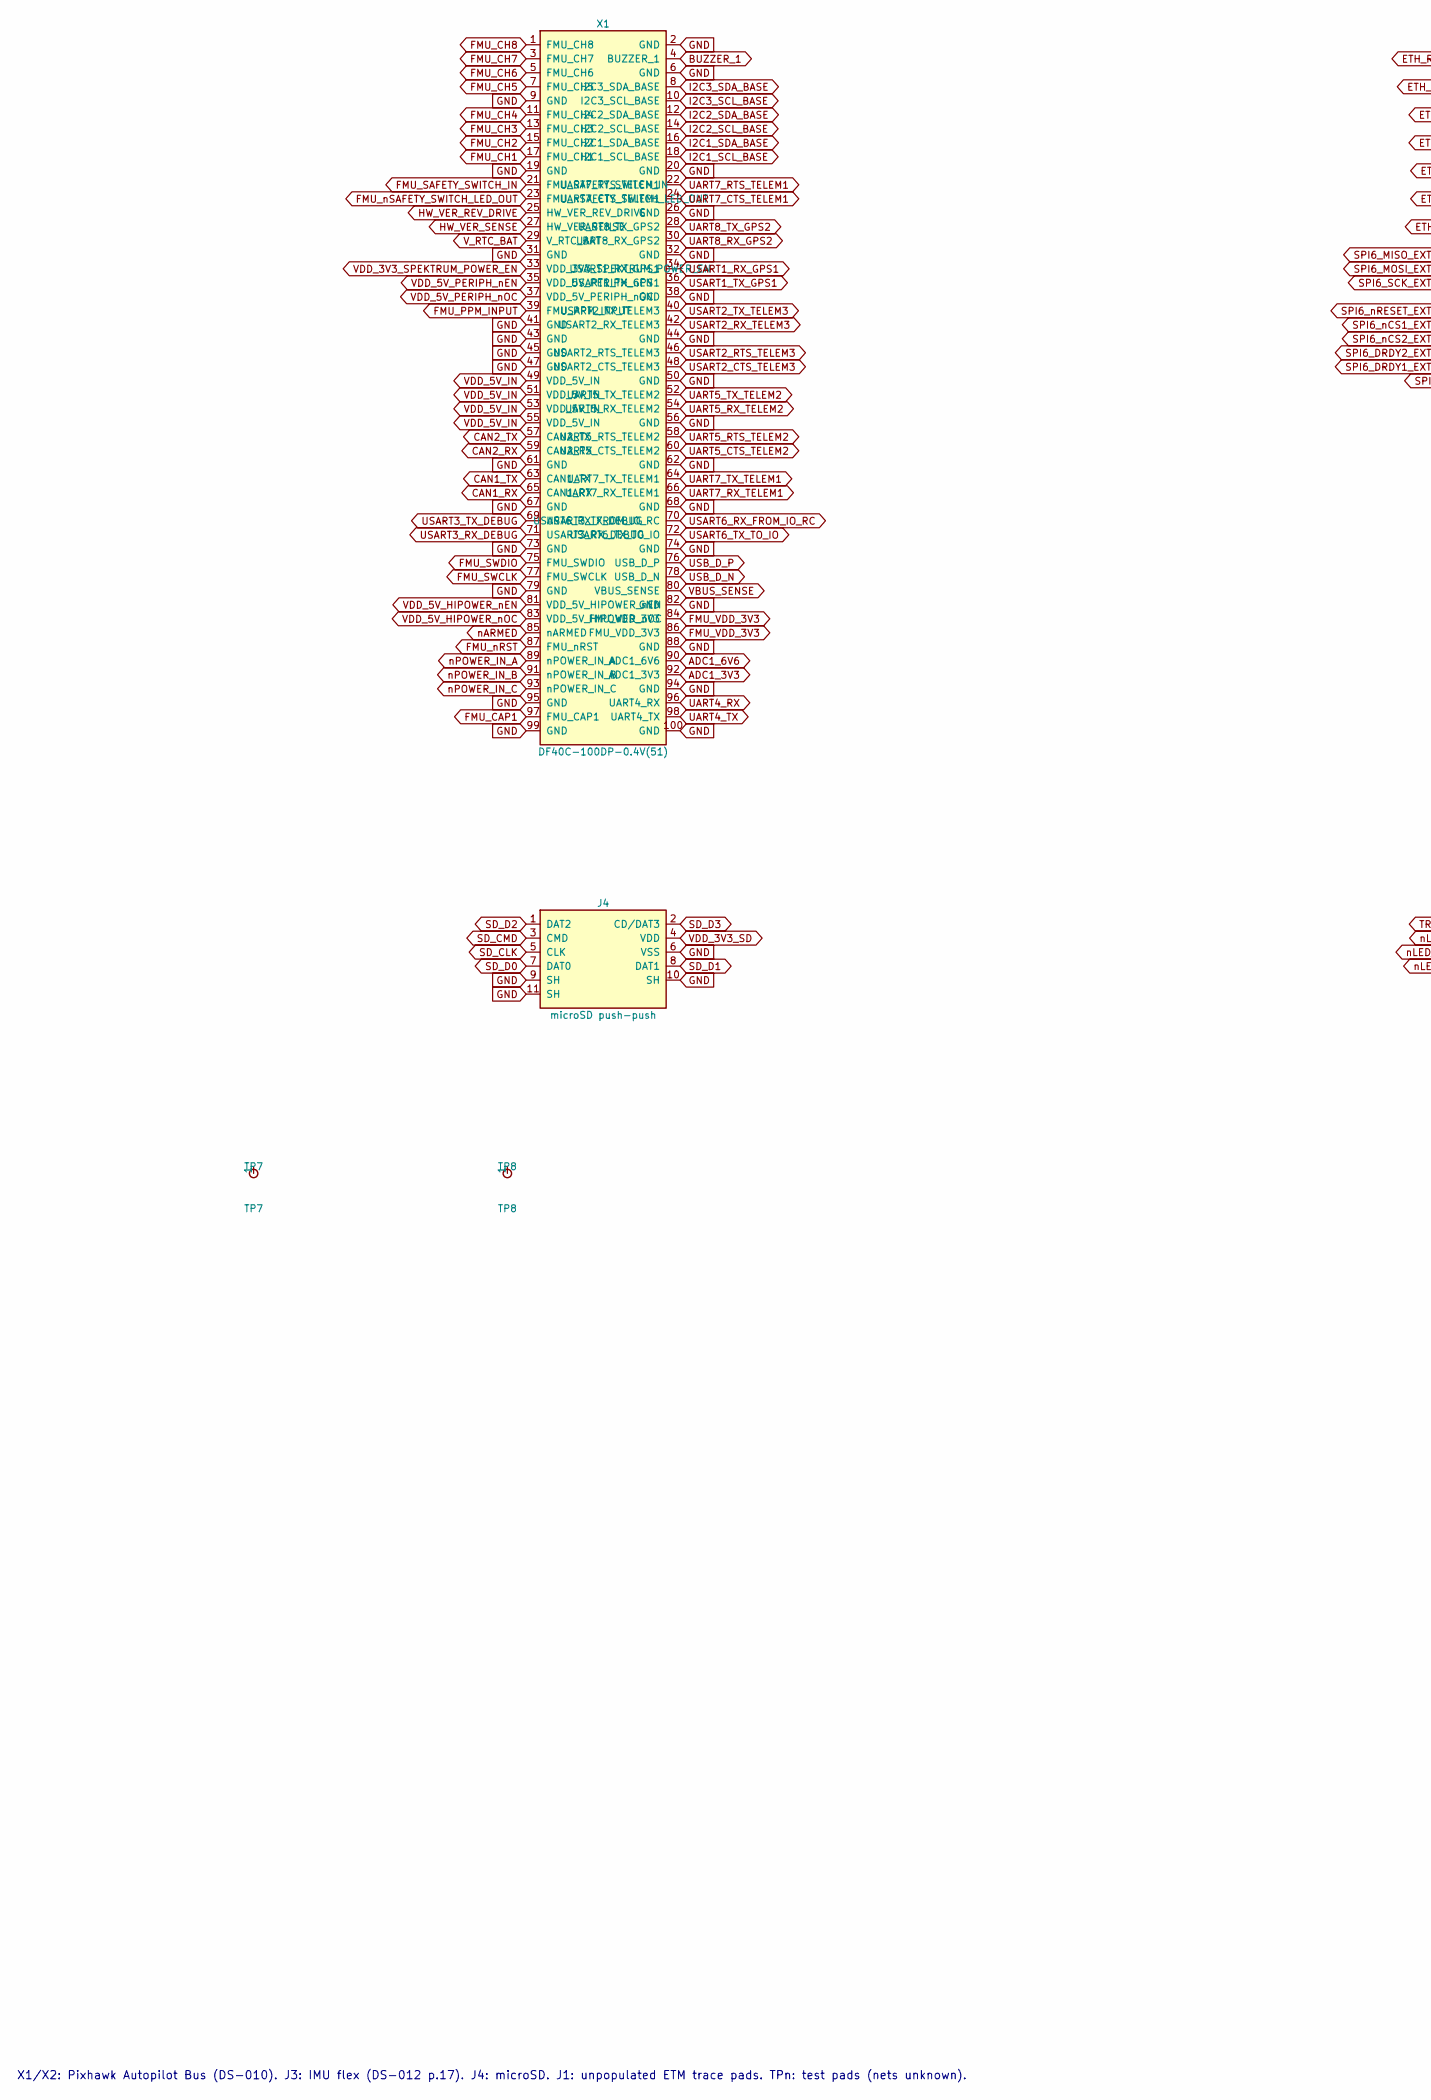
[picture p7: schematic 02_connectors.kicad_sch, part in row 1, column 1]

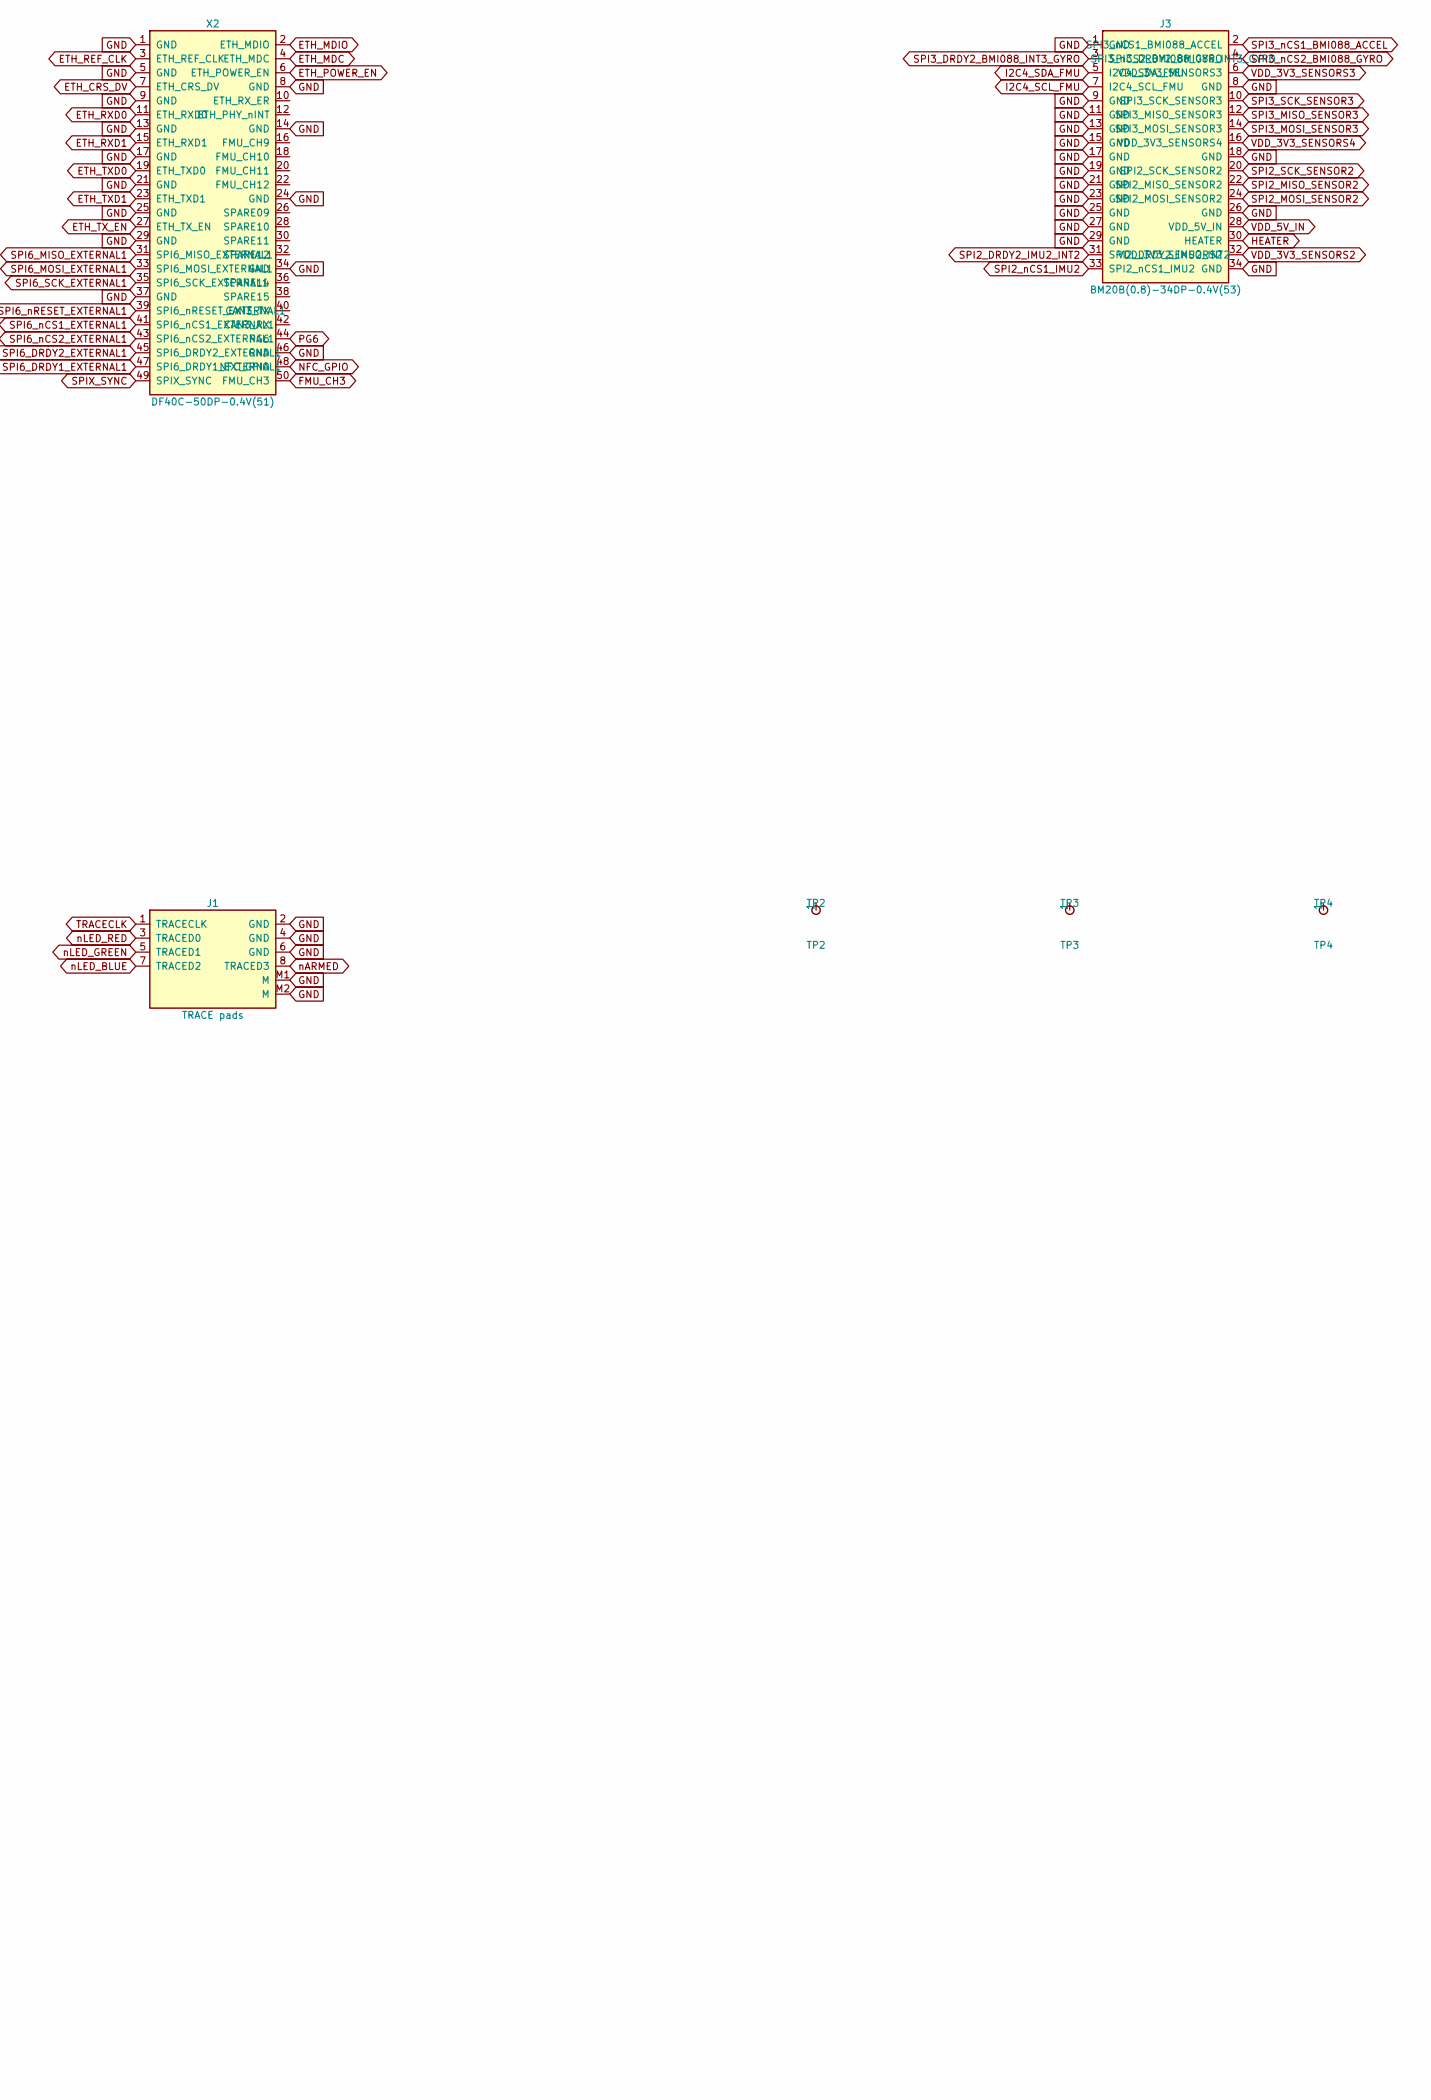
[picture p8: schematic 02_connectors.kicad_sch, part in row 1, column 2]

Parts:
J1: TRACE pads; TRACE_8+2
J3: BM20B(0.8)-34DP-0.4V(53); Hirose_BM20B-34-0.4V
J4: microSD push-push; microSD_HC_Molex_104031-0811
TP2: TP2; TestPad_1.0mm
TP3: TP3; TestPad_1.0mm
TP4: TP4; TestPad_1.0mm
TP7: TP7; TestPad_1.0mm
TP8: TP8; TestPad_1.0mm
X1: DF40C-100DP-0.4V(51); Hirose_DF40C-100DP-0.4V
X2: DF40C-50DP-0.4V(51); Hirose_DF40C-50DP-0.4V

Connections:
ADC1_3V3: X1.92 (ADC1_3V3); also elsewhere on the board
ADC1_6V6: X1.90 (ADC1_6V6); also elsewhere on the board
BUZZER_1: X1.4 (BUZZER_1); also elsewhere on the board
CAN1_RX: X1.65 (CAN1_RX); also elsewhere on the board
CAN1_TX: X1.63 (CAN1_TX); also elsewhere on the board
CAN2_RX: X1.59 (CAN2_RX); also elsewhere on the board
CAN2_TX: X1.57 (CAN2_TX); also elsewhere on the board
ETH_CRS_DV: X2.7 (ETH_CRS_DV); also elsewhere on the board
ETH_MDC: X2.4 (ETH_MDC); also elsewhere on the board
ETH_MDIO: X2.2 (ETH_MDIO); also elsewhere on the board
ETH_POWER_EN: X2.6 (ETH_POWER_EN); also elsewhere on the board
ETH_REF_CLK: X2.3 (ETH_REF_CLK); also elsewhere on the board
ETH_RXD0: X2.11 (ETH_RXD0); also elsewhere on the board
ETH_RXD1: X2.15 (ETH_RXD1); also elsewhere on the board
ETH_TXD0: X2.19 (ETH_TXD0); also elsewhere on the board
ETH_TXD1: X2.23 (ETH_TXD1); also elsewhere on the board
ETH_TX_EN: X2.27 (ETH_TX_EN); also elsewhere on the board
FMU_CAP1: X1.97 (FMU_CAP1); also elsewhere on the board
FMU_CH1: X1.17 (FMU_CH1); also elsewhere on the board
FMU_CH2: X1.15 (FMU_CH2); also elsewhere on the board
FMU_CH3: X1.13 (FMU_CH3), X2.50 (FMU_CH3); also elsewhere on the board
FMU_CH4: X1.11 (FMU_CH4); also elsewhere on the board
FMU_CH5: X1.7 (FMU_CH5); also elsewhere on the board
FMU_CH6: X1.5 (FMU_CH6); also elsewhere on the board
FMU_CH7: X1.3 (FMU_CH7); also elsewhere on the board
FMU_CH8: X1.1 (FMU_CH8); also elsewhere on the board
FMU_PPM_INPUT: X1.39 (FMU_PPM_INPUT); also elsewhere on the board
FMU_SAFETY_SWITCH_IN: X1.21 (FMU_SAFETY_SWITCH_IN); also elsewhere on the board
FMU_SWCLK: X1.77 (FMU_SWCLK); also elsewhere on the board
FMU_SWDIO: X1.75 (FMU_SWDIO); also elsewhere on the board
FMU_VDD_3V3: X1.84 (FMU_VDD_3V3), X1.86 (FMU_VDD_3V3); also elsewhere on the board
FMU_nRST: X1.87 (FMU_nRST); also elsewhere on the board
FMU_nSAFETY_SWITCH_LED_OUT: X1.23 (FMU_nSAFETY_SWITCH_LED_OUT); also elsewhere on the board
GND: J1.2 (GND), J1.4 (GND), J1.6 (GND), J1.M1 (M), J1.M2 (M), J3.1 (GND), J3.8 (GND), J3.9 (GND), J3.11 (GND), J3.13 (GND), J3.15 (GND), J3.17 (GND), J3.18 (GND), J3.19 (GND), J3.21 (GND), J3.23 (GND), J3.25 (GND), J3.26 (GND), J3.27 (GND), J3.29 (GND), J3.34 (GND), J4.6 (VSS), J4.9 (SH), J4.10 (SH), J4.11 (SH), X1.2 (GND), X1.6 (GND), X1.9 (GND), X1.19 (GND), X1.20 (GND), X1.26 (GND), X1.31 (GND), X1.32 (GND), X1.38 (GND), X1.41 (GND), X1.43 (GND), X1.44 (GND), X1.45 (GND), X1.47 (GND), X1.50 (GND), X1.56 (GND), X1.61 (GND), X1.62 (GND), X1.67 (GND), X1.68 (GND), X1.73 (GND), X1.74 (GND), X1.79 (GND), X1.82 (GND), X1.88 (GND), X1.94 (GND), X1.95 (GND), X1.99 (GND), X1.100 (GND), X2.1 (GND), X2.5 (GND), X2.8 (GND), X2.9 (GND), X2.13 (GND), X2.14 (GND), X2.17 (GND), X2.21 (GND), X2.24 (GND), X2.25 (GND), X2.29 (GND), X2.34 (GND), X2.37 (GND), X2.46 (GND); also elsewhere on the board
HEATER: J3.30 (HEATER); also elsewhere on the board
HW_VER_REV_DRIVE: X1.25 (HW_VER_REV_DRIVE); also elsewhere on the board
HW_VER_SENSE: X1.27 (HW_VER_SENSE); also elsewhere on the board
I2C1_SCL_BASE: X1.18 (I2C1_SCL_BASE); also elsewhere on the board
I2C1_SDA_BASE: X1.16 (I2C1_SDA_BASE); also elsewhere on the board
I2C2_SCL_BASE: X1.14 (I2C2_SCL_BASE); also elsewhere on the board
I2C2_SDA_BASE: X1.12 (I2C2_SDA_BASE); also elsewhere on the board
I2C3_SCL_BASE: X1.10 (I2C3_SCL_BASE); also elsewhere on the board
I2C3_SDA_BASE: X1.8 (I2C3_SDA_BASE); also elsewhere on the board
I2C4_SCL_FMU: J3.7 (I2C4_SCL_FMU); also elsewhere on the board
I2C4_SDA_FMU: J3.5 (I2C4_SDA_FMU); also elsewhere on the board
NFC_GPIO: X2.48 (NFC_GPIO); also elsewhere on the board
PG6: X2.44 (PG6); also elsewhere on the board
SD_CLK: J4.5 (CLK); also elsewhere on the board
SD_CMD: J4.3 (CMD); also elsewhere on the board
SD_D0: J4.7 (DAT0); also elsewhere on the board
SD_D1: J4.8 (DAT1); also elsewhere on the board
SD_D2: J4.1 (DAT2); also elsewhere on the board
SD_D3: J4.2 (CD/DAT3); also elsewhere on the board
SPI2_DRDY2_IMU2_INT2: J3.31 (SPI2_DRDY2_IMU2_INT2); also elsewhere on the board
SPI2_MISO_SENSOR2: J3.22 (SPI2_MISO_SENSOR2); also elsewhere on the board
SPI2_MOSI_SENSOR2: J3.24 (SPI2_MOSI_SENSOR2); also elsewhere on the board
SPI2_SCK_SENSOR2: J3.20 (SPI2_SCK_SENSOR2); also elsewhere on the board
SPI2_nCS1_IMU2: J3.33 (SPI2_nCS1_IMU2); also elsewhere on the board
SPI3_DRDY2_BMI088_INT3_GYRO: J3.3 (SPI3_DRDY2_BMI088_INT3_GYRO); also elsewhere on the board
SPI3_MISO_SENSOR3: J3.12 (SPI3_MISO_SENSOR3); also elsewhere on the board
SPI3_MOSI_SENSOR3: J3.14 (SPI3_MOSI_SENSOR3); also elsewhere on the board
SPI3_SCK_SENSOR3: J3.10 (SPI3_SCK_SENSOR3); also elsewhere on the board
SPI3_nCS1_BMI088_ACCEL: J3.2 (SPI3_nCS1_BMI088_ACCEL); also elsewhere on the board
SPI3_nCS2_BMI088_GYRO: J3.4 (SPI3_nCS2_BMI088_GYRO); also elsewhere on the board
SPI6_DRDY1_EXTERNAL1: X2.47 (SPI6_DRDY1_EXTERNAL1); also elsewhere on the board
SPI6_DRDY2_EXTERNAL1: X2.45 (SPI6_DRDY2_EXTERNAL1); also elsewhere on the board
SPI6_MISO_EXTERNAL1: X2.31 (SPI6_MISO_EXTERNAL1); also elsewhere on the board
SPI6_MOSI_EXTERNAL1: X2.33 (SPI6_MOSI_EXTERNAL1); also elsewhere on the board
SPI6_SCK_EXTERNAL1: X2.35 (SPI6_SCK_EXTERNAL1); also elsewhere on the board
SPI6_nCS1_EXTERNAL1: X2.41 (SPI6_nCS1_EXTERNAL1); also elsewhere on the board
SPI6_nCS2_EXTERNAL1: X2.43 (SPI6_nCS2_EXTERNAL1); also elsewhere on the board
SPI6_nRESET_EXTERNAL1: X2.39 (SPI6_nRESET_EXTERNAL1); also elsewhere on the board
SPIX_SYNC: X2.49 (SPIX_SYNC); also elsewhere on the board
TRACECLK: J1.1 (TRACECLK); also elsewhere on the board
UART4_RX: X1.96 (UART4_RX); also elsewhere on the board
UART4_TX: X1.98 (UART4_TX); also elsewhere on the board
UART5_CTS_TELEM2: X1.60 (UART5_CTS_TELEM2); also elsewhere on the board
UART5_RTS_TELEM2: X1.58 (UART5_RTS_TELEM2); also elsewhere on the board
UART5_RX_TELEM2: X1.54 (UART5_RX_TELEM2); also elsewhere on the board
UART5_TX_TELEM2: X1.52 (UART5_TX_TELEM2); also elsewhere on the board
UART7_CTS_TELEM1: X1.24 (UART7_CTS_TELEM1); also elsewhere on the board
UART7_RTS_TELEM1: X1.22 (UART7_RTS_TELEM1); also elsewhere on the board
UART7_RX_TELEM1: X1.66 (UART7_RX_TELEM1); also elsewhere on the board
UART7_TX_TELEM1: X1.64 (UART7_TX_TELEM1); also elsewhere on the board
UART8_RX_GPS2: X1.30 (UART8_RX_GPS2); also elsewhere on the board
UART8_TX_GPS2: X1.28 (UART8_TX_GPS2); also elsewhere on the board
USART1_RX_GPS1: X1.34 (USART1_RX_GPS1); also elsewhere on the board
USART1_TX_GPS1: X1.36 (USART1_TX_GPS1); also elsewhere on the board
USART2_CTS_TELEM3: X1.48 (USART2_CTS_TELEM3); also elsewhere on the board
USART2_RTS_TELEM3: X1.46 (USART2_RTS_TELEM3); also elsewhere on the board
USART2_RX_TELEM3: X1.42 (USART2_RX_TELEM3); also elsewhere on the board
USART2_TX_TELEM3: X1.40 (USART2_TX_TELEM3); also elsewhere on the board
USART3_RX_DEBUG: X1.71 (USART3_RX_DEBUG); also elsewhere on the board
USART3_TX_DEBUG: X1.69 (USART3_TX_DEBUG); also elsewhere on the board
USART6_RX_FROM_IO_RC: X1.70 (USART6_RX_FROM_IO_RC); also elsewhere on the board
USART6_TX_TO_IO: X1.72 (USART6_TX_TO_IO); also elsewhere on the board
USB_D_N: X1.78 (USB_D_N); also elsewhere on the board
USB_D_P: X1.76 (USB_D_P); also elsewhere on the board
VBUS_SENSE: X1.80 (VBUS_SENSE); also elsewhere on the board
VDD_3V3_SD: J4.4 (VDD); also elsewhere on the board
VDD_3V3_SENSORS2: J3.32 (VDD_3V3_SENSORS2); also elsewhere on the board
VDD_3V3_SENSORS3: J3.6 (VDD_3V3_SENSORS3); also elsewhere on the board
VDD_3V3_SENSORS4: J3.16 (VDD_3V3_SENSORS4); also elsewhere on the board
VDD_3V3_SPEKTRUM_POWER_EN: X1.33 (VDD_3V3_SPEKTRUM_POWER_EN); also elsewhere on the board
VDD_5V_HIPOWER_nEN: X1.81 (VDD_5V_HIPOWER_nEN); also elsewhere on the board
VDD_5V_HIPOWER_nOC: X1.83 (VDD_5V_HIPOWER_nOC); also elsewhere on the board
VDD_5V_IN: J3.28 (VDD_5V_IN), X1.49 (VDD_5V_IN), X1.51 (VDD_5V_IN), X1.53 (VDD_5V_IN), X1.55 (VDD_5V_IN); also elsewhere on the board
VDD_5V_PERIPH_nEN: X1.35 (VDD_5V_PERIPH_nEN); also elsewhere on the board
VDD_5V_PERIPH_nOC: X1.37 (VDD_5V_PERIPH_nOC); also elsewhere on the board
V_RTC_BAT: X1.29 (V_RTC_BAT); also elsewhere on the board
nARMED: J1.8 (TRACED3), X1.85 (nARMED); also elsewhere on the board
nLED_BLUE: J1.7 (TRACED2); also elsewhere on the board
nLED_GREEN: J1.5 (TRACED1); also elsewhere on the board
nLED_RED: J1.3 (TRACED0); also elsewhere on the board
nPOWER_IN_A: X1.89 (nPOWER_IN_A); also elsewhere on the board
nPOWER_IN_B: X1.91 (nPOWER_IN_B); also elsewhere on the board
nPOWER_IN_C: X1.93 (nPOWER_IN_C); also elsewhere on the board

Notes on the sheet:
X1/X2: Pixhawk Autopilot Bus (DS-010). J3: IMU flex (DS-012 p.17). J4: microSD. J1: unpopulated ETM trace pads. TPn: test pads (nets unknown).

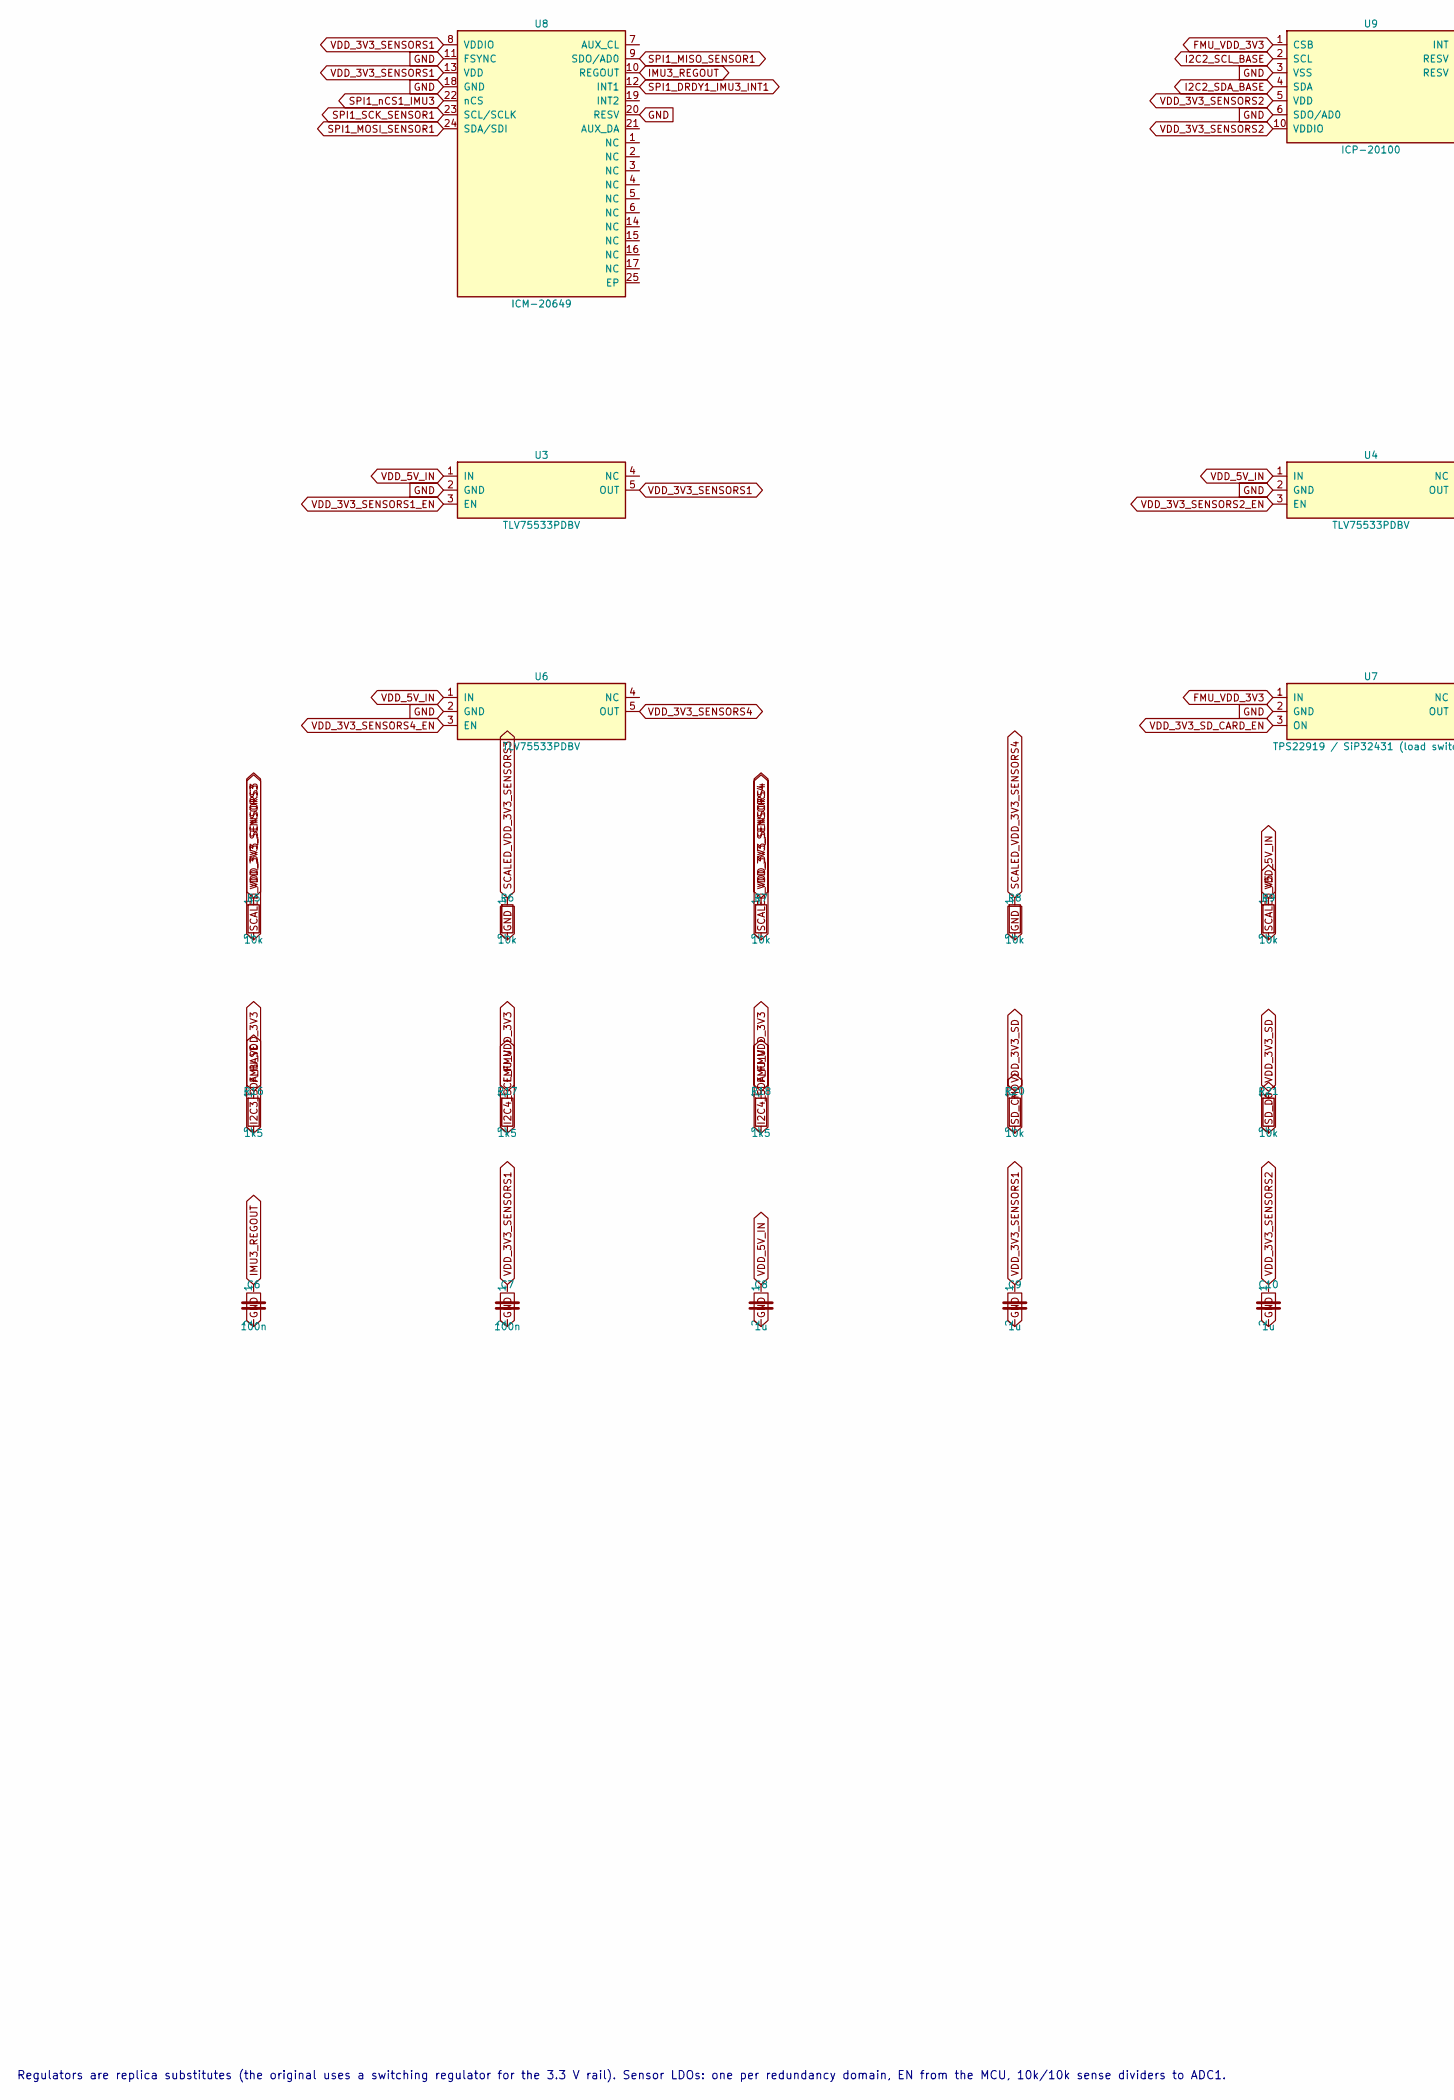
[picture p9: schematic 03_power_sensors.kicad_sch, part in row 1, column 1]

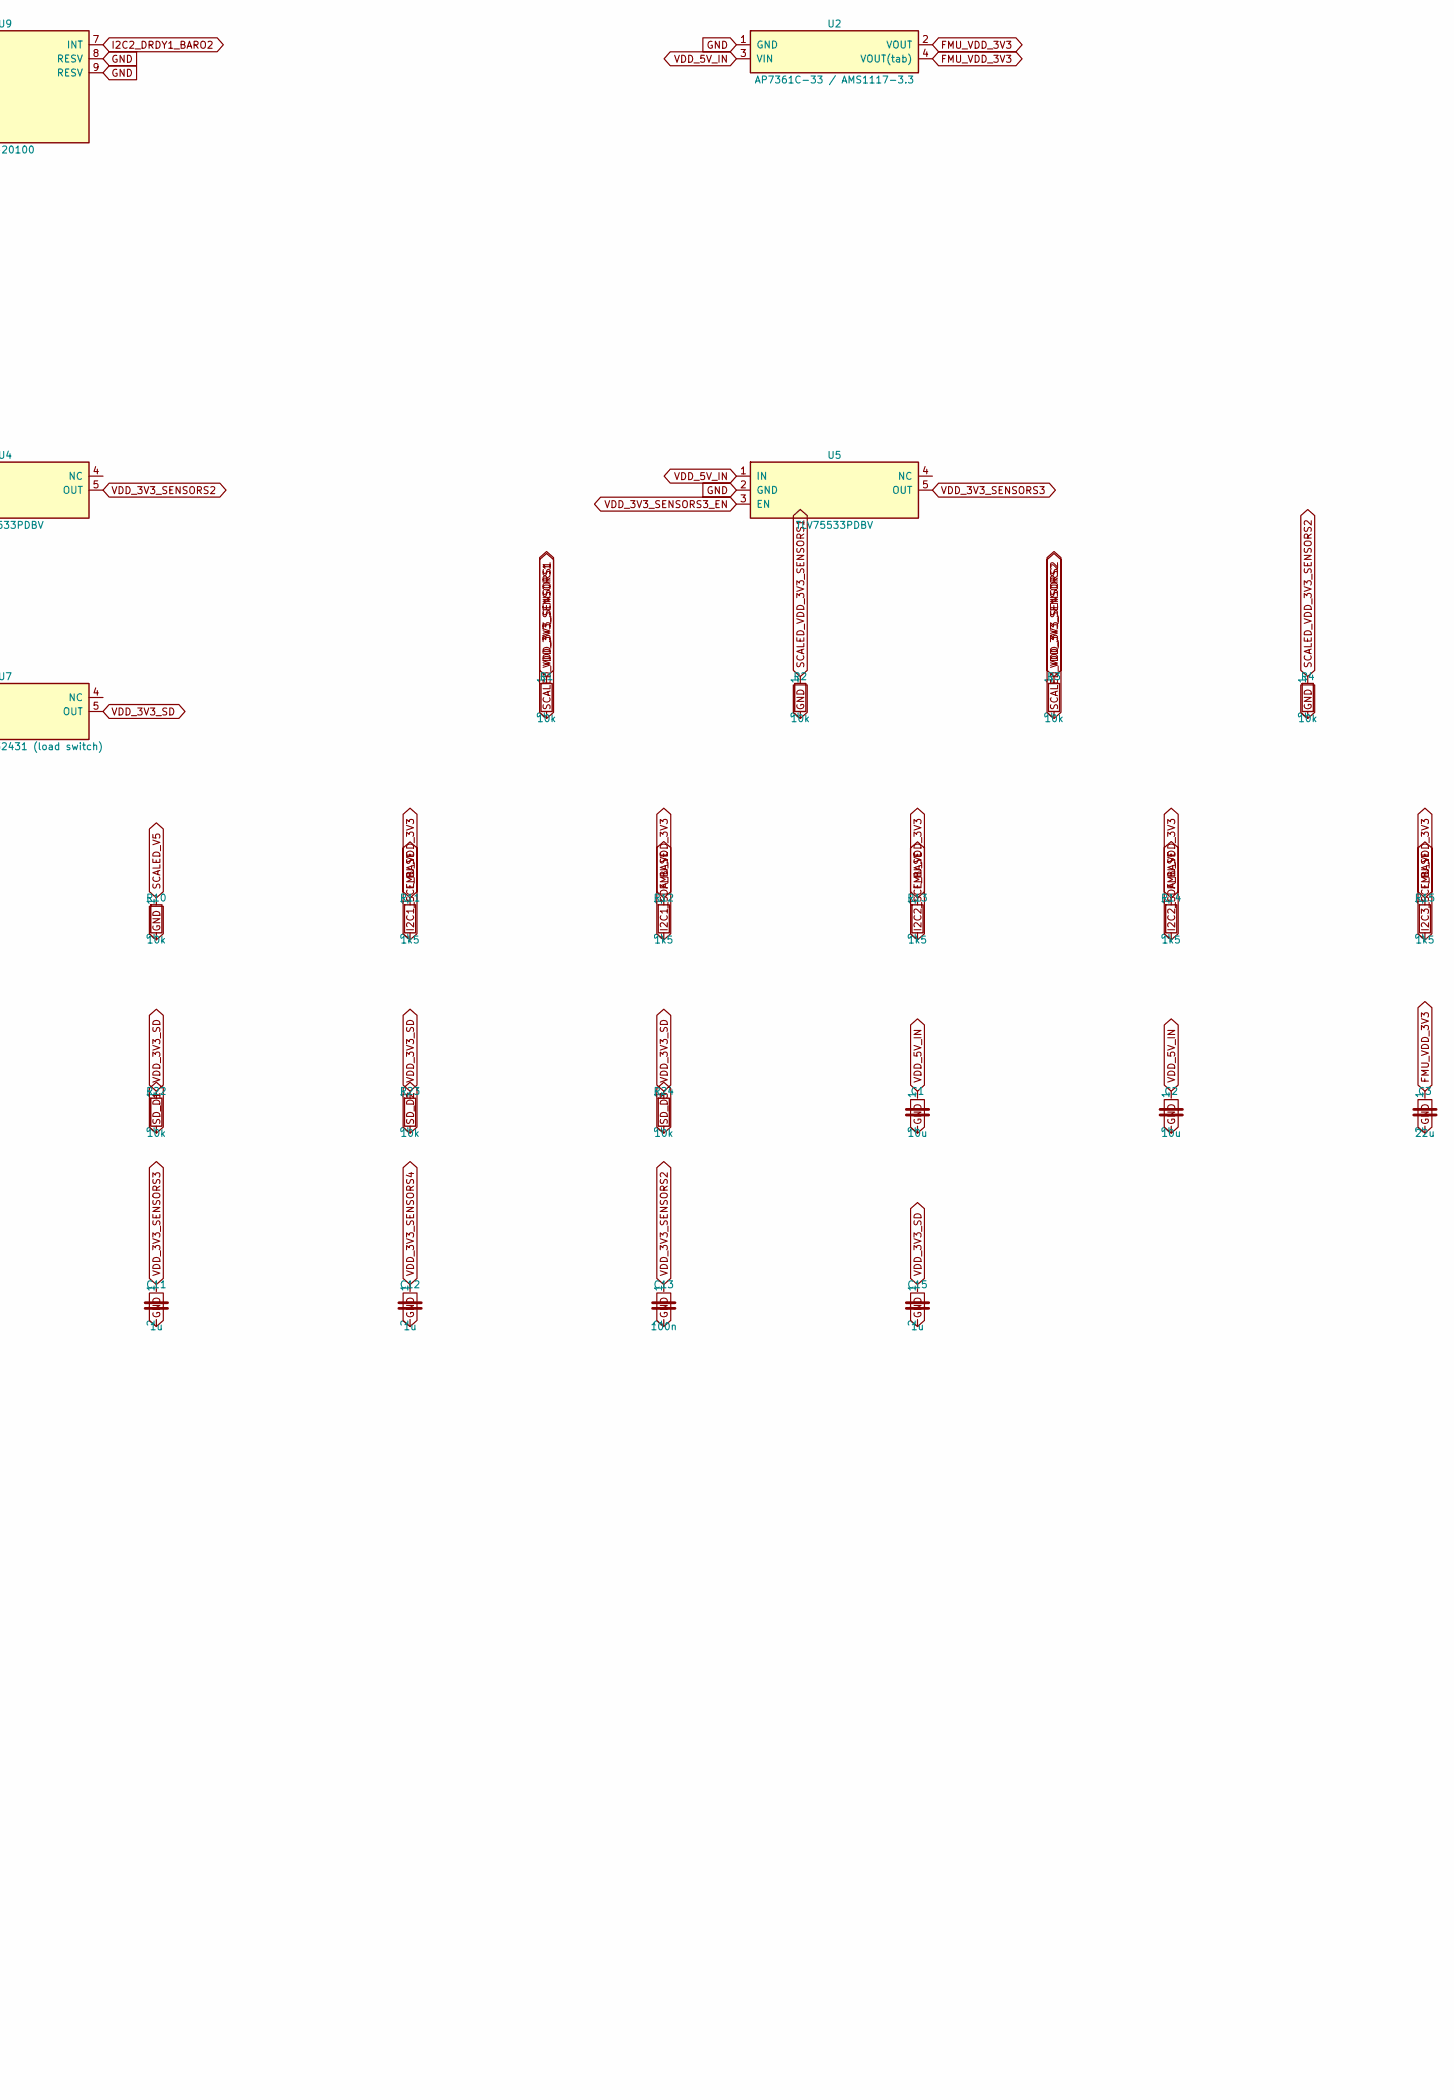
[picture p10: schematic 03_power_sensors.kicad_sch, part in row 1, column 2]

Parts:
C1, C2: 10u; C_0603_1608Metric
C3: 22u; C_0805_2012Metric
C6, C7, C13: 100n; C_0402_1005Metric
C8, C9, C10, C11, C12, C15: 1u; C_0402_1005Metric
R1, R2, R3, R4, R5, R6, R7, R8, R9, R10, R20, R21, R22, R23, R24: 10k; R_0402_1005Metric
R11, R12, R13, R14, R15, R16, R17, R18: 1k5; R_0402_1005Metric
U2: AP7361C-33 / AMS1117-3.3; SOT-223-3_TabPin2
U3, U4, U5, U6: TLV75533PDBV; SOT-23-5
U7: TPS22919 / SiP32431 (load switch); SOT-23-5
U8: ICM-20649; QFN-24-1EP_3x3mm_P0.4mm_EP1.75x1.6mm
U9: ICP-20100; TDK_LGA-10_2x2mm_P0.5mm

Connections:
FMU_VDD_3V3: C3.1, R11.1, R12.1, R13.1, R14.1, R15.1, R16.1, R17.1, R18.1, U2.2 (VOUT), U2.4 (VOUT(tab)), U7.1 (IN), U9.1 (CSB); also elsewhere on the board
GND: C1.2, C2.2, C3.2, C6.2, C7.2, C8.2, C9.2, C10.2, C11.2, C12.2, C13.2, C15.2, R2.2, R4.2, R6.2, R8.2, R10.2, U2.1 (GND), U3.2 (GND), U4.2 (GND), U5.2 (GND), U6.2 (GND), U7.2 (GND), U8.11 (FSYNC), U8.18 (GND), U8.20 (RESV), U9.3 (VSS), U9.6 (SDO/AD0), U9.8 (RESV), U9.9 (RESV); also elsewhere on the board
I2C1_SCL_BASE: R11.2; also elsewhere on the board
I2C1_SDA_BASE: R12.2; also elsewhere on the board
I2C2_DRDY1_BARO2: U9.7 (INT); also elsewhere on the board
I2C2_SCL_BASE: R13.2, U9.2 (SCL); also elsewhere on the board
I2C2_SDA_BASE: R14.2, U9.4 (SDA); also elsewhere on the board
I2C3_SCL_BASE: R15.2; also elsewhere on the board
I2C3_SDA_BASE: R16.2; also elsewhere on the board
I2C4_SCL_FMU: R17.2; also elsewhere on the board
I2C4_SDA_FMU: R18.2; also elsewhere on the board
IMU3_REGOUT: C6.1, U8.10 (REGOUT)
SCALED_V5: R9.2, R10.1; also elsewhere on the board
SCALED_VDD_3V3_SENSORS1: R1.2, R2.1; also elsewhere on the board
SCALED_VDD_3V3_SENSORS2: R3.2, R4.1; also elsewhere on the board
SCALED_VDD_3V3_SENSORS3: R5.2, R6.1; also elsewhere on the board
SCALED_VDD_3V3_SENSORS4: R7.2, R8.1; also elsewhere on the board
SD_CMD: R20.2; also elsewhere on the board
SD_D0: R21.2; also elsewhere on the board
SD_D1: R22.2; also elsewhere on the board
SD_D2: R23.2; also elsewhere on the board
SD_D3: R24.2; also elsewhere on the board
SPI1_DRDY1_IMU3_INT1: U8.12 (INT1); also elsewhere on the board
SPI1_MISO_SENSOR1: U8.9 (SDO/AD0); also elsewhere on the board
SPI1_MOSI_SENSOR1: U8.24 (SDA/SDI); also elsewhere on the board
SPI1_SCK_SENSOR1: U8.23 (SCL/SCLK); also elsewhere on the board
SPI1_nCS1_IMU3: U8.22 (nCS); also elsewhere on the board
VDD_3V3_SD: C15.1, R20.1, R21.1, R22.1, R23.1, R24.1, U7.5 (OUT); also elsewhere on the board
VDD_3V3_SD_CARD_EN: U7.3 (ON); also elsewhere on the board
VDD_3V3_SENSORS1: C7.1, C9.1, R1.1, U3.5 (OUT), U8.8 (VDDIO), U8.13 (VDD)
VDD_3V3_SENSORS1_EN: U3.3 (EN); also elsewhere on the board
VDD_3V3_SENSORS2: C10.1, C13.1, R3.1, U4.5 (OUT), U9.5 (VDD), U9.10 (VDDIO); also elsewhere on the board
VDD_3V3_SENSORS2_EN: U4.3 (EN); also elsewhere on the board
VDD_3V3_SENSORS3: C11.1, R5.1, U5.5 (OUT); also elsewhere on the board
VDD_3V3_SENSORS3_EN: U5.3 (EN); also elsewhere on the board
VDD_3V3_SENSORS4: C12.1, R7.1, U6.5 (OUT); also elsewhere on the board
VDD_3V3_SENSORS4_EN: U6.3 (EN); also elsewhere on the board
VDD_5V_IN: C1.1, C2.1, C8.1, R9.1, U2.3 (VIN), U3.1 (IN), U4.1 (IN), U5.1 (IN), U6.1 (IN); also elsewhere on the board

Notes on the sheet:
Regulators are replica substitutes (the original uses a switching regulator for the 3.3 V rail). Sensor LDOs: one per redundancy domain, EN from the MCU, 10k/10k sense dividers to ADC1.
