eloyf26/PX4-Autopilot/hardware/cuav_v6x_fmum/kicad/fmum/cuav_v6x_fmum.kicad_pcb

## KiCad design hardware/cuav_v6x_fmum/kicad/fmum/cuav_v6x_fmum.kicad_pcb (continued)

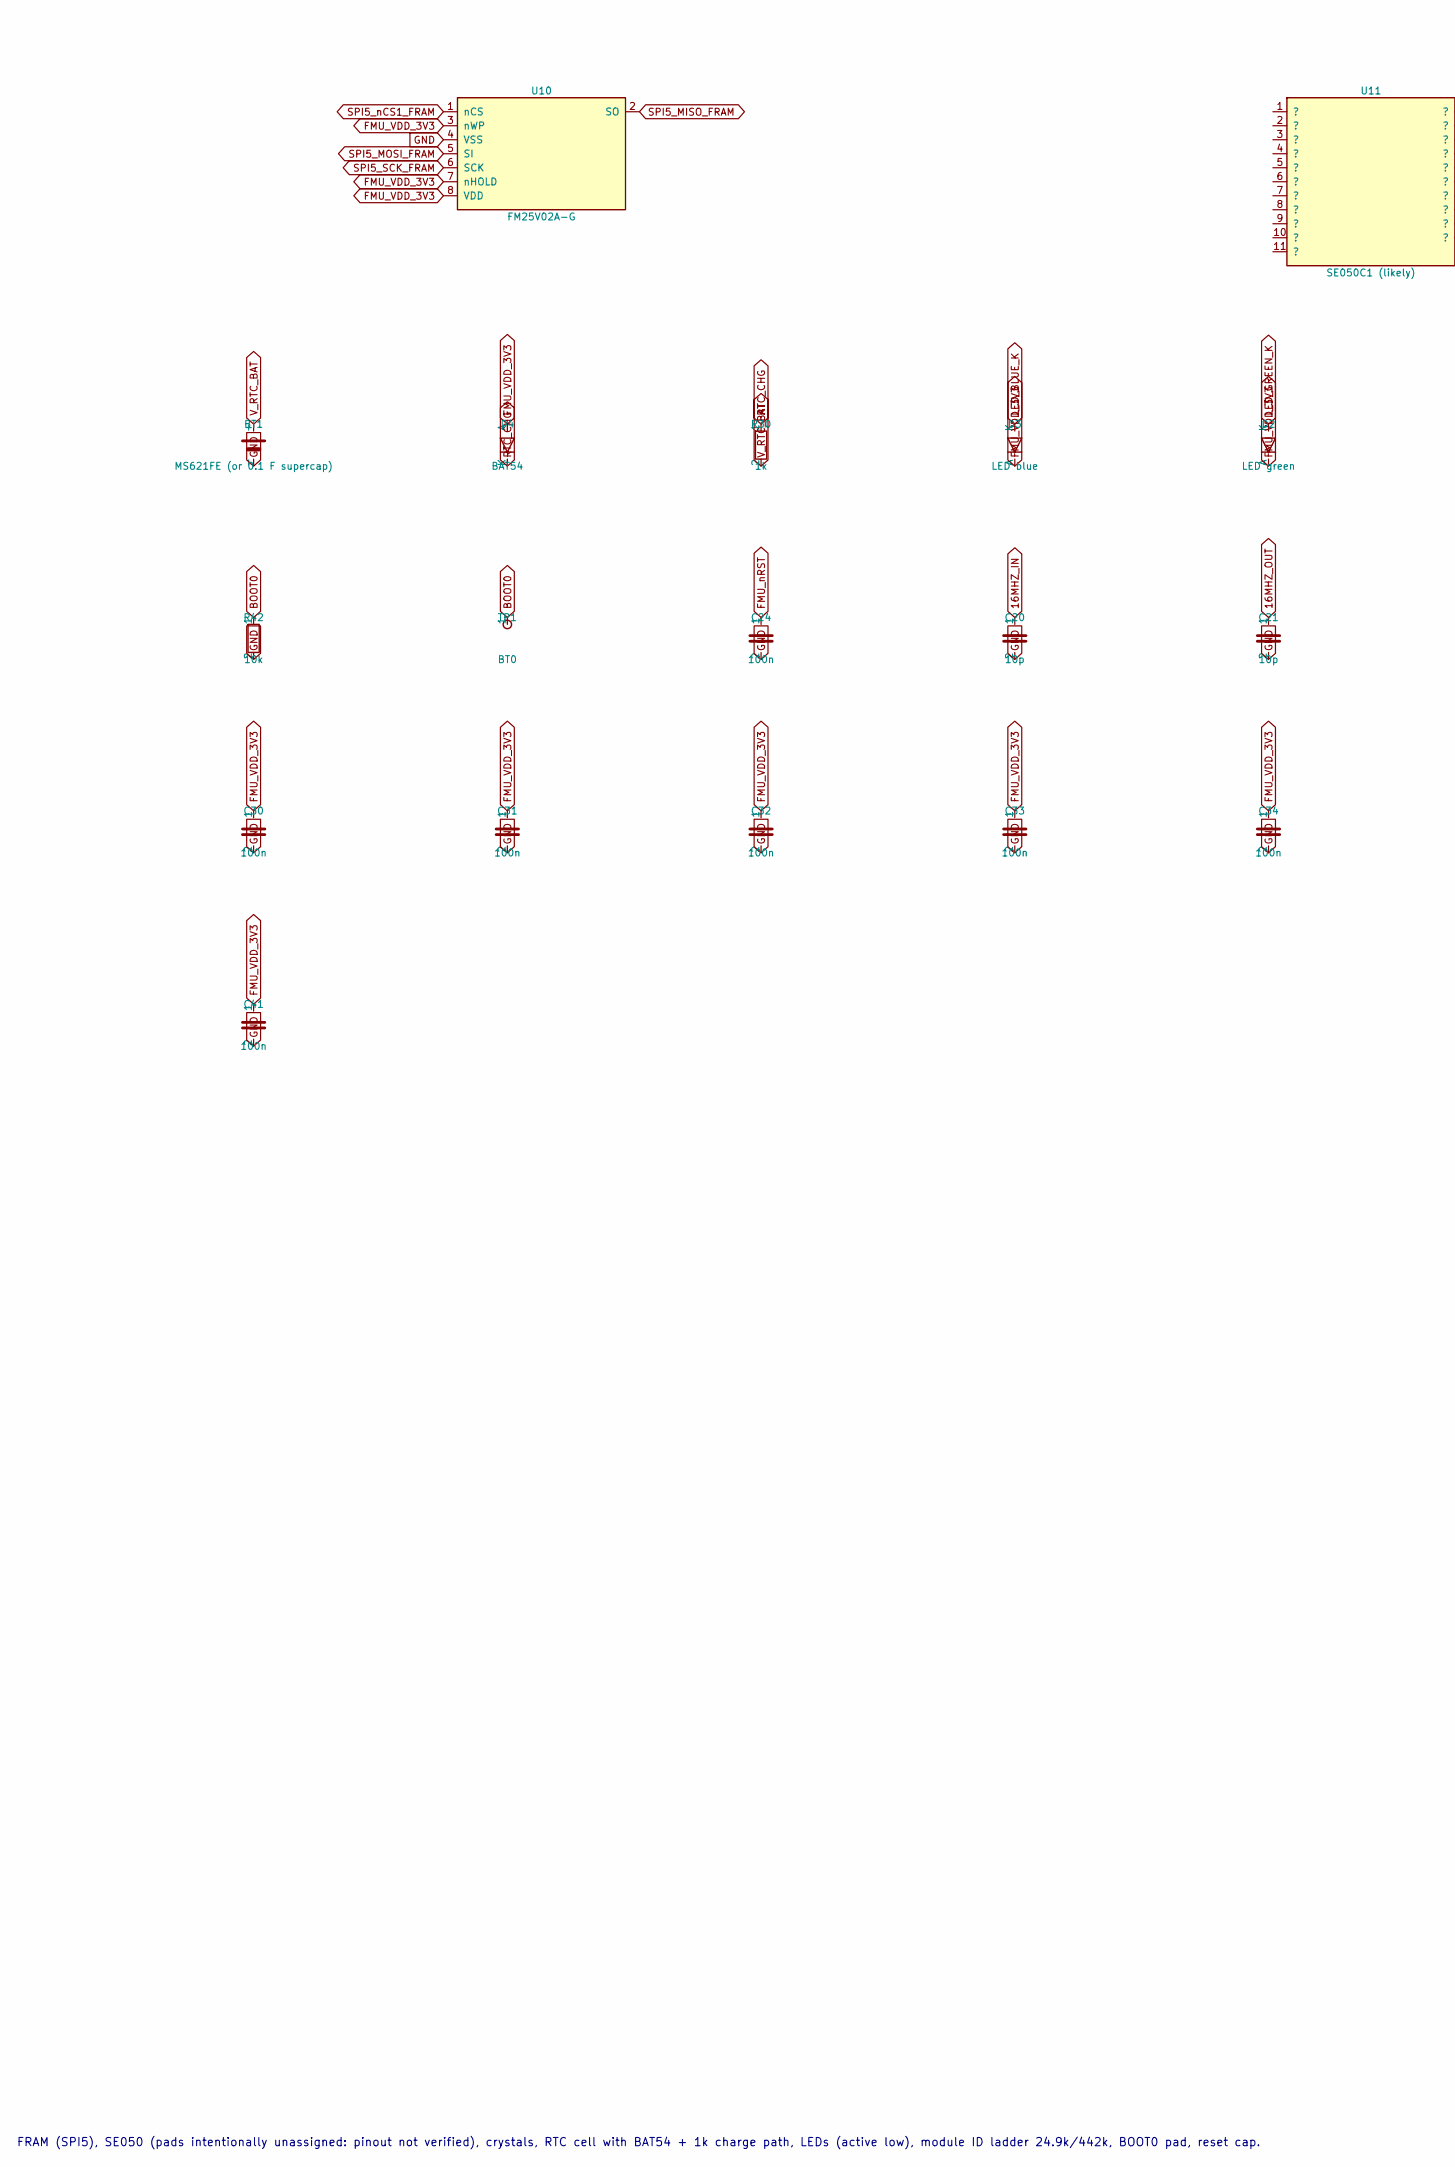
[picture p11: schematic 04_core.kicad_sch, part in row 1, column 1]

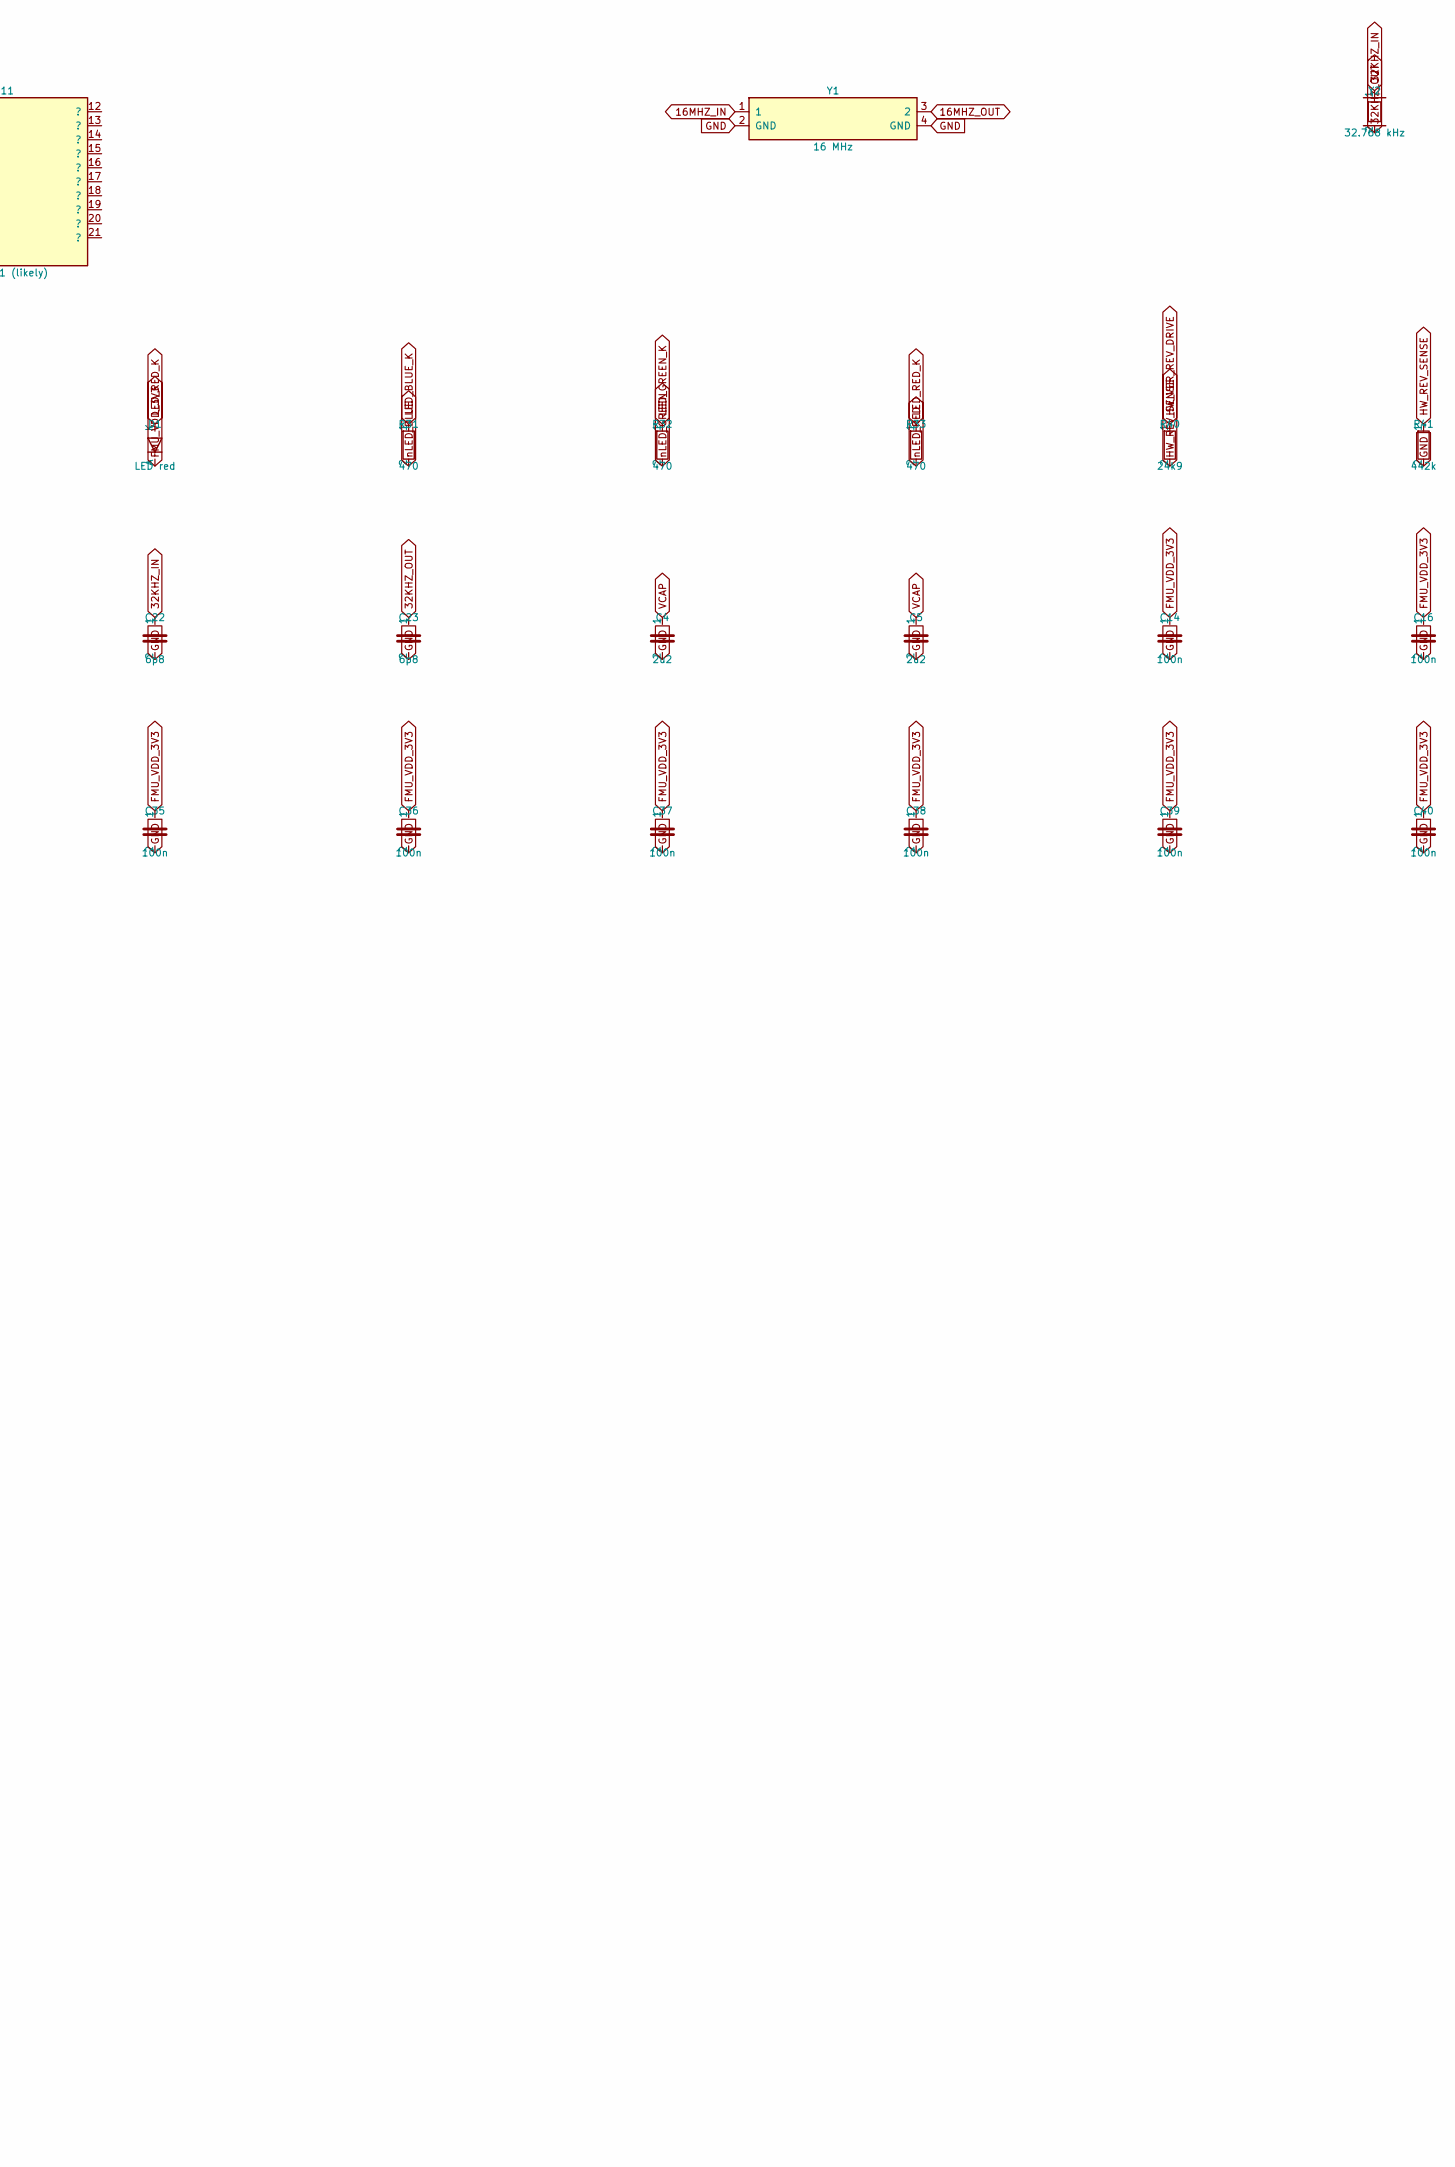
[picture p12: schematic 04_core.kicad_sch, part in row 1, column 2]

Parts:
BT1: MS621FE (or 0.1 F supercap); Seiko_MS621FE
C4, C5: 2u2; C_0402_1005Metric
C14, C16, C24, C30, C31, C32, C33, C34, C35, C36, C37, C38, C39, C40, C41: 100n; C_0402_1005Metric
C20, C21: 10p; C_0402_1005Metric
C22, C23: 6p8; C_0402_1005Metric
D1: LED red; LED_0603_1608Metric
D2: LED green; LED_0603_1608Metric
D3: LED blue; LED_0603_1608Metric
D4: BAT54; D_SOD-323
R30: 1k; R_0402_1005Metric
R31, R32, R33: 470; R_0402_1005Metric
R40: 24k9; R_0402_1005Metric
R41: 442k; R_0402_1005Metric
R42: 10k; R_0402_1005Metric
TP1: BT0; TestPad_1.0mm
U10: FM25V02A-G; SOIC-8_3.9x4.9mm_P1.27mm
U11: SE050C1 (likely); QFN-20-1EP_3x3mm_P0.4mm_EP1.65x1.65mm
Y1: 16 MHz; Crystal_SMD_3225-4Pin_3.2x2.5mm
Y2: 32.768 kHz; Crystal_SMD_3215-2Pin_3.2x1.5mm

Connections:
16MHZ_IN: C20.1, Y1.1; also elsewhere on the board
16MHZ_OUT: C21.1, Y1.3 (2); also elsewhere on the board
32KHZ_IN: C22.1, Y2.1; also elsewhere on the board
32KHZ_OUT: C23.1, Y2.2; also elsewhere on the board
BOOT0: R42.1, TP1.1; also elsewhere on the board
FMU_VDD_3V3: C14.1, C16.1, C30.1, C31.1, C32.1, C33.1, C34.1, C35.1, C36.1, C37.1, C38.1, C39.1, C40.1, C41.1, D1.2 (A), D2.2 (A), D3.2 (A), D4.1 (A), U10.3 (nWP), U10.7 (nHOLD), U10.8 (VDD); also elsewhere on the board
FMU_nRST: C24.1; also elsewhere on the board
GND: BT1.2 (-), C4.2, C5.2, C14.2, C16.2, C20.2, C21.2, C22.2, C23.2, C24.2, C30.2, C31.2, C32.2, C33.2, C34.2, C35.2, C36.2, C37.2, C38.2, C39.2, C40.2, C41.2, R41.2, R42.2, U10.4 (VSS), Y1.2 (GND), Y1.4 (GND); also elsewhere on the board
HW_REV_SENSE: R40.2, R41.1; also elsewhere on the board
HW_VER_REV_DRIVE: R40.1; also elsewhere on the board
LED_BLUE_K: D3.1 (K), R31.1
LED_GREEN_K: D2.1 (K), R32.1
LED_RED_K: D1.1 (K), R33.1
RTC_CHG: D4.2 (K), R30.1
SPI5_MISO_FRAM: U10.2 (SO); also elsewhere on the board
SPI5_MOSI_FRAM: U10.5 (SI); also elsewhere on the board
SPI5_SCK_FRAM: U10.6 (SCK); also elsewhere on the board
SPI5_nCS1_FRAM: U10.1 (nCS); also elsewhere on the board
VCAP: C4.1, C5.1; also elsewhere on the board
V_RTC_BAT: BT1.1 (+), R30.2; also elsewhere on the board
nLED_BLUE: R31.2; also elsewhere on the board
nLED_GREEN: R32.2; also elsewhere on the board
nLED_RED: R33.2; also elsewhere on the board

Notes on the sheet:
FRAM (SPI5), SE050 (pads intentionally unassigned: pinout not verified), crystals, RTC cell with BAT54 + 1k charge path, LEDs (active low), module ID ladder 24.9k/442k, BOOT0 pad, reset cap.

Board: 6 copper layers, 96 parts (55 on the bottom side), 150 nets, no tracks yet.

Other parts of the board:
H1, H2, H3, H4: M2 GND; HOLE

Their connections:
GND: H1.1, H2.1, H3.1, H4.1; also elsewhere on the board
