eloyf26/PX4-Autopilot/hardware/cuav_v6x_fmum/kicad/imu/cuav_v6x_imu.kicad_pcb

## KiCad design hardware/cuav_v6x_fmum/kicad/imu/cuav_v6x_imu.kicad_pcb (2026-09-11)

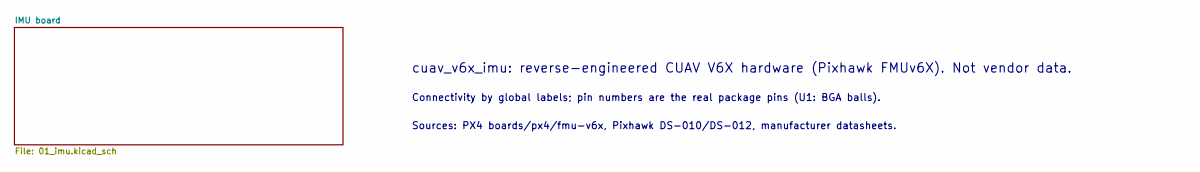
[picture p13: schematic cuav_v6x_imu.kicad_sch]

Notes on the sheet:
cuav_v6x_imu: reverse-engineered CUAV V6X hardware (Pixhawk FMUv6X). Not vendor data.
Connectivity by global labels; pin numbers are the real package pins (U1: BGA balls).
Sources: PX4 boards/px4/fmu-v6x, Pixhawk DS-010/DS-012, manufacturer datasheets.

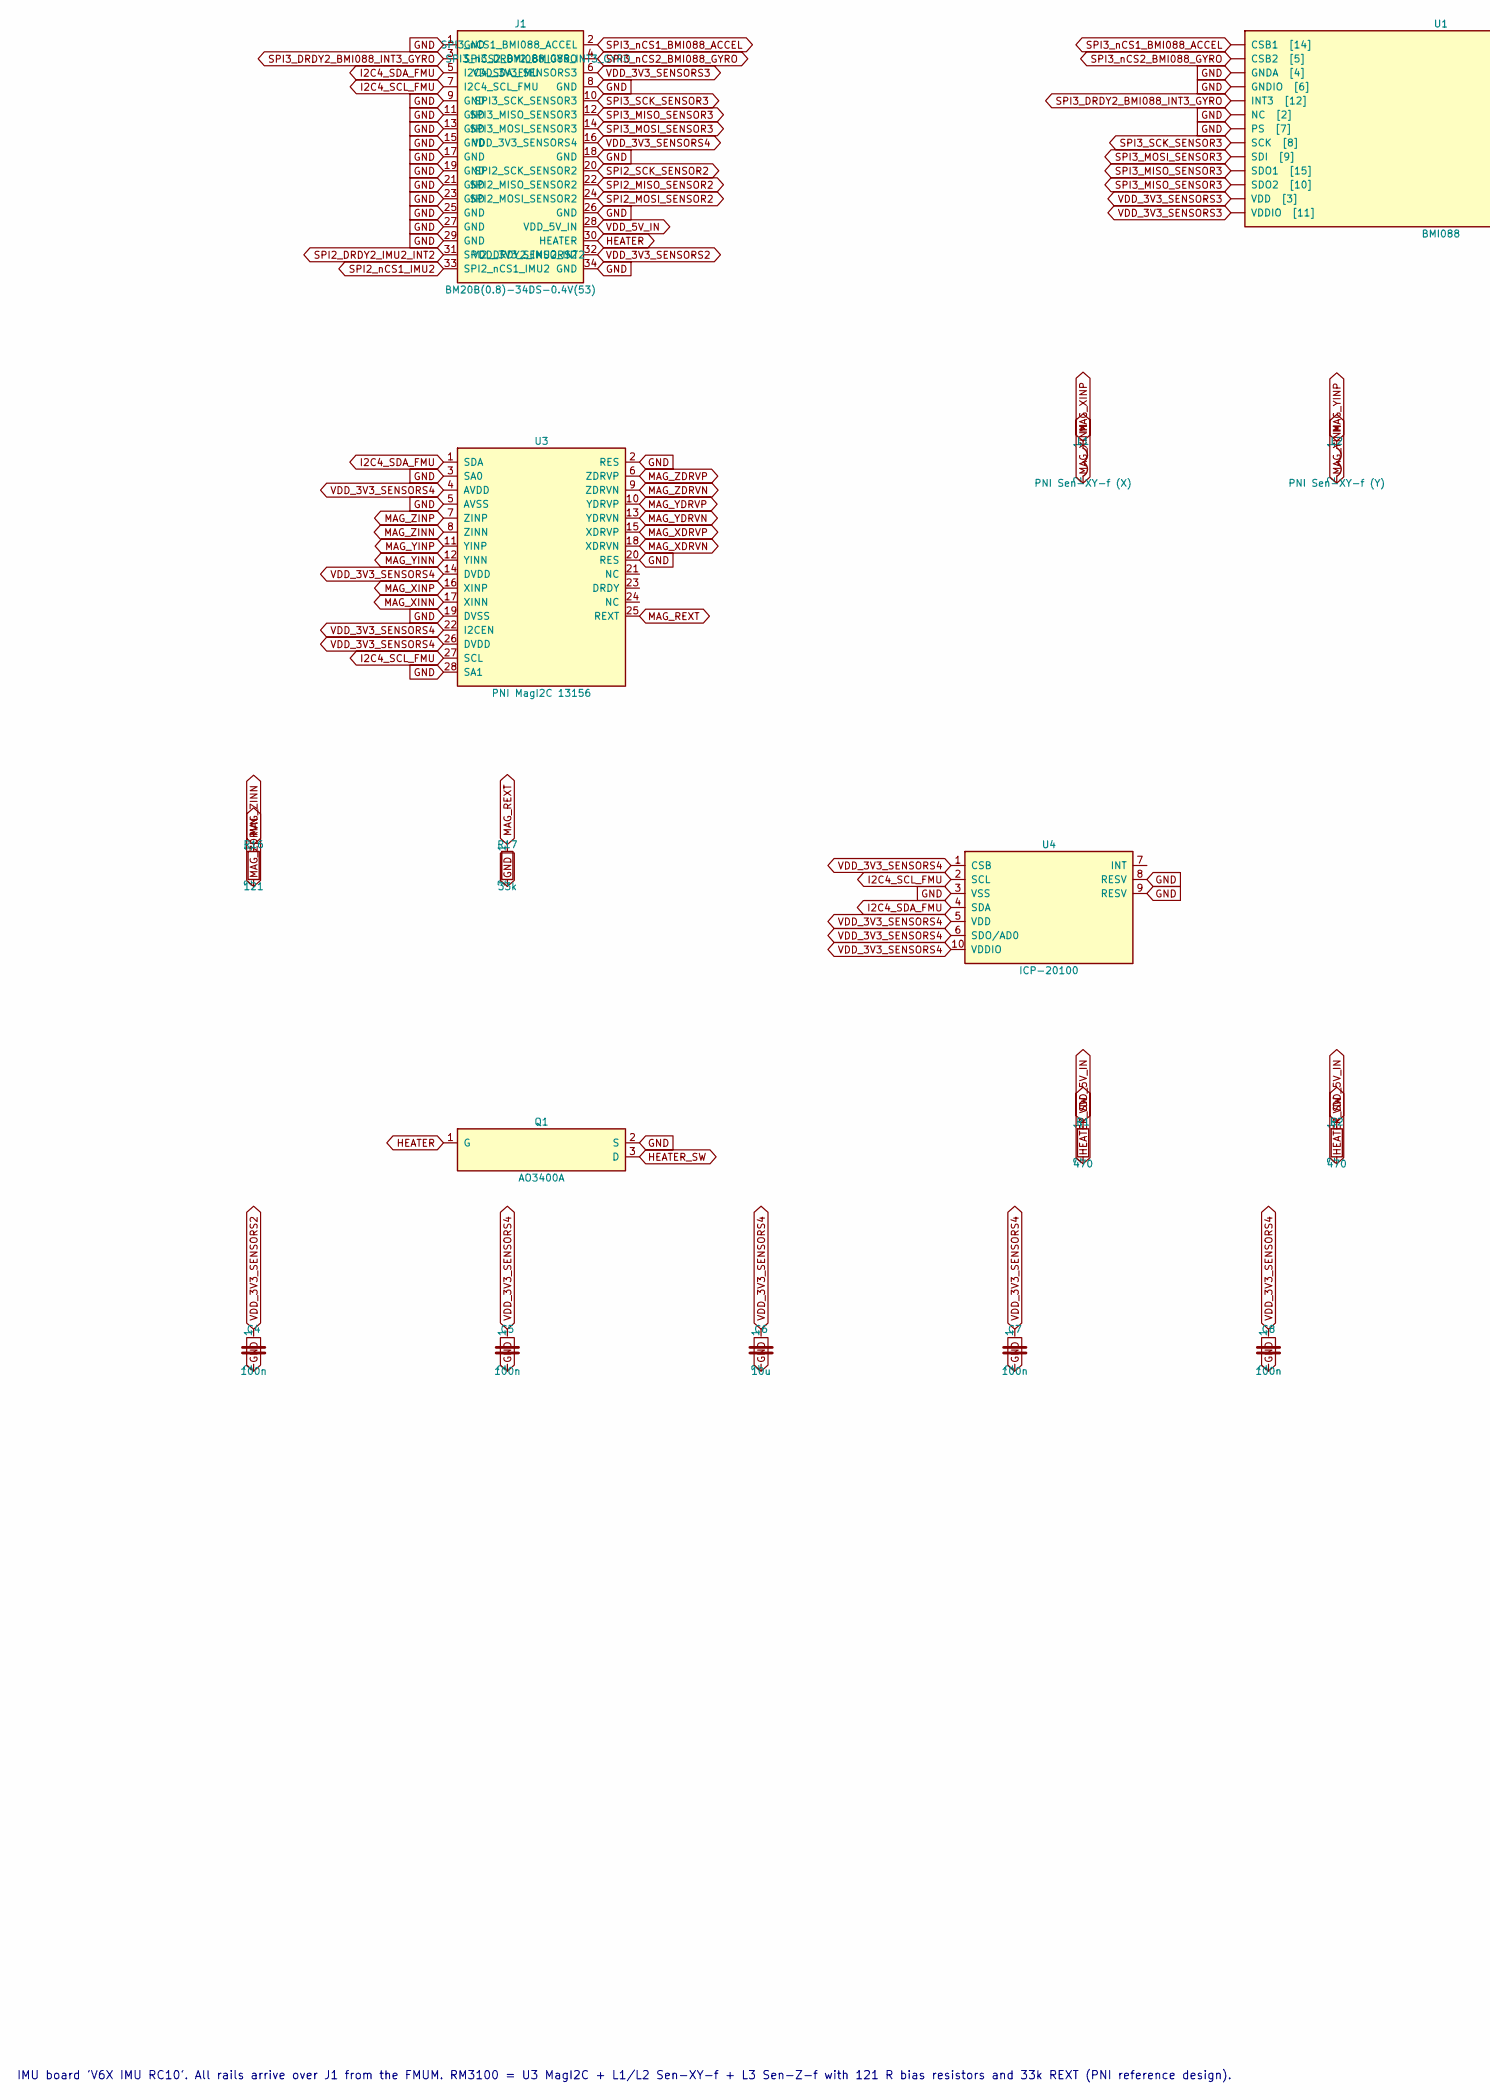
[picture p14: schematic 01_imu.kicad_sch, part in row 1, column 1]

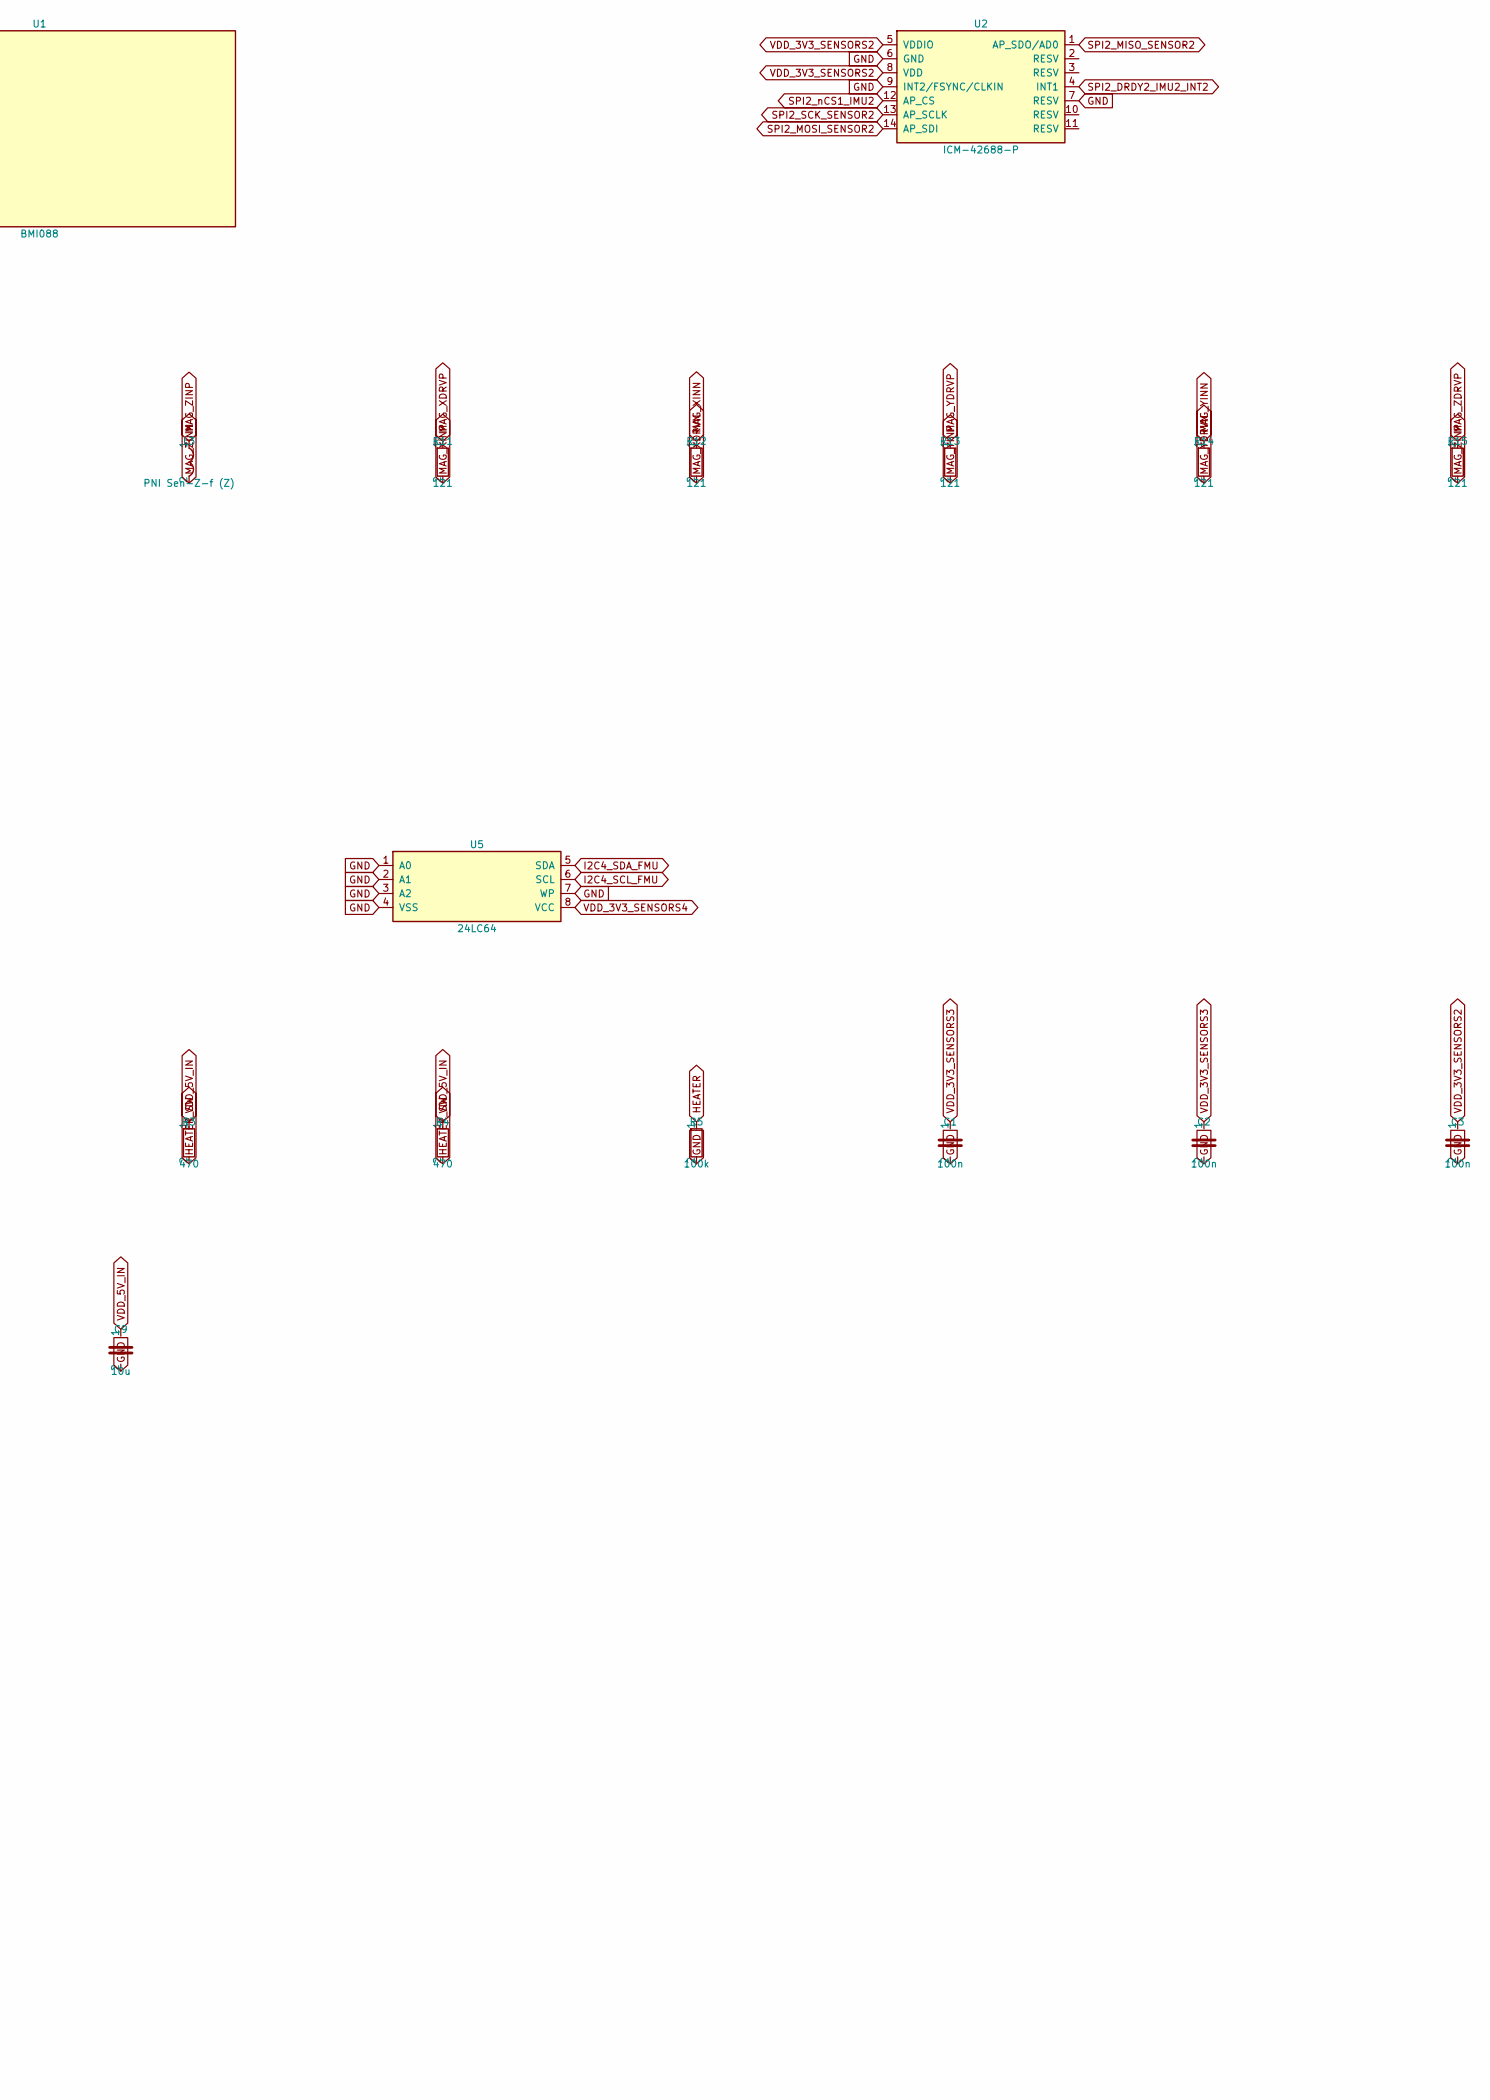
[picture p15: schematic 01_imu.kicad_sch, part in row 1, column 2]

Parts:
C1, C2, C3, C4, C5, C7, C8: 100n; C_0402_1005Metric
C6, C9: 10u; C_0603_1608Metric
J1: BM20B(0.8)-34DS-0.4V(53); Hirose_BM20B-34-0.4V
L1: PNI Sen-XY-f (X); PNI_Sen-XY-f
L2: PNI Sen-XY-f (Y); PNI_Sen-XY-f
L3: PNI Sen-Z-f (Z); PNI_Sen-Z-f
Q1: AO3400A; SOT-23
R1, R2, R3, R4: 470; R_0805_2012Metric
R5: 100k; R_0402_1005Metric
R11, R12, R13, R14, R15, R16: 121; R_0402_1005Metric
R17: 33k; R_0402_1005Metric
U1: BMI088; Bosch_LGA-16_4.5x3mm_P0.5mm
U2: ICM-42688-P; LGA-14_3x2.5mm_P0.5mm_LayoutBorder3x4y
U3: PNI MagI2C 13156; PNI_MLF-28_4x4mm_P0.4mm
U4: ICP-20100; TDK_LGA-10_2x2mm_P0.5mm
U5: 24LC64; SOIC-8_3.9x4.9mm_P1.27mm

Connections:
GND: C1.2, C2.2, C3.2, C4.2, C5.2, C6.2, C7.2, C8.2, C9.2, J1.1 (GND), J1.8 (GND), J1.9 (GND), J1.11 (GND), J1.13 (GND), J1.15 (GND), J1.17 (GND), J1.18 (GND), J1.19 (GND), J1.21 (GND), J1.23 (GND), J1.25 (GND), J1.26 (GND), J1.27 (GND), J1.29 (GND), J1.34 (GND), Q1.2 (S), R5.2, R17.2, U1.2 (NC [2]), U1.4 (GNDA [4]), U1.6 (GNDIO [6]), U1.7 (PS [7]), U2.6 (GND), U2.7 (RESV), U2.9 (INT2/FSYNC/CLKIN), U3.2 (RES), U3.3 (SA0), U3.5 (AVSS), U3.19 (DVSS), U3.20 (RES), U3.28 (SA1), U4.3 (VSS), U4.8 (RESV), U4.9 (RESV), U5.1 (A0), U5.2 (A1), U5.3 (A2), U5.4 (VSS), U5.7 (WP); also elsewhere on the board
HEATER: J1.30 (HEATER), Q1.1 (G), R5.1
HEATER_SW: Q1.3 (D), R1.2, R2.2, R3.2, R4.2
I2C4_SCL_FMU: J1.7 (I2C4_SCL_FMU), U3.27 (SCL), U4.2 (SCL), U5.6 (SCL)
I2C4_SDA_FMU: J1.5 (I2C4_SDA_FMU), U3.1 (SDA), U4.4 (SDA), U5.5 (SDA)
MAG_REXT: R17.1, U3.25 (REXT)
MAG_XDRVN: R12.2, U3.18 (XDRVN)
MAG_XDRVP: R11.1, U3.15 (XDRVP)
MAG_XINN: L1.2, R12.1, U3.17 (XINN)
MAG_XINP: L1.1, R11.2, U3.16 (XINP)
MAG_YDRVN: R14.2, U3.13 (YDRVN)
MAG_YDRVP: R13.1, U3.10 (YDRVP)
MAG_YINN: L2.2, R14.1, U3.12 (YINN)
MAG_YINP: L2.1, R13.2, U3.11 (YINP)
MAG_ZDRVN: R16.2, U3.9 (ZDRVN)
MAG_ZDRVP: R15.1, U3.6 (ZDRVP)
MAG_ZINN: L3.2, R16.1, U3.8 (ZINN)
MAG_ZINP: L3.1, R15.2, U3.7 (ZINP)
SPI2_DRDY2_IMU2_INT2: J1.31 (SPI2_DRDY2_IMU2_INT2), U2.4 (INT1)
SPI2_MISO_SENSOR2: J1.22 (SPI2_MISO_SENSOR2), U2.1 (AP_SDO/AD0)
SPI2_MOSI_SENSOR2: J1.24 (SPI2_MOSI_SENSOR2), U2.14 (AP_SDI)
SPI2_SCK_SENSOR2: J1.20 (SPI2_SCK_SENSOR2), U2.13 (AP_SCLK)
SPI2_nCS1_IMU2: J1.33 (SPI2_nCS1_IMU2), U2.12 (AP_CS)
SPI3_DRDY2_BMI088_INT3_GYRO: J1.3 (SPI3_DRDY2_BMI088_INT3_GYRO), U1.12 (INT3 [12])
SPI3_MISO_SENSOR3: J1.12 (SPI3_MISO_SENSOR3), U1.10 (SDO2 [10]), U1.15 (SDO1 [15])
SPI3_MOSI_SENSOR3: J1.14 (SPI3_MOSI_SENSOR3), U1.9 (SDI [9])
SPI3_SCK_SENSOR3: J1.10 (SPI3_SCK_SENSOR3), U1.8 (SCK [8])
SPI3_nCS1_BMI088_ACCEL: J1.2 (SPI3_nCS1_BMI088_ACCEL), U1.14 (CSB1 [14])
SPI3_nCS2_BMI088_GYRO: J1.4 (SPI3_nCS2_BMI088_GYRO), U1.5 (CSB2 [5])
VDD_3V3_SENSORS2: C3.1, C4.1, J1.32 (VDD_3V3_SENSORS2), U2.5 (VDDIO), U2.8 (VDD)
VDD_3V3_SENSORS3: C1.1, C2.1, J1.6 (VDD_3V3_SENSORS3), U1.3 (VDD [3]), U1.11 (VDDIO [11])
VDD_3V3_SENSORS4: C5.1, C6.1, C7.1, C8.1, J1.16 (VDD_3V3_SENSORS4), U3.4 (AVDD), U3.14 (DVDD), U3.22 (I2CEN), U3.26 (DVDD), U4.1 (CSB), U4.5 (VDD), U4.6 (SDO/AD0), U4.10 (VDDIO), U5.8 (VCC)
VDD_5V_IN: C9.1, J1.28 (VDD_5V_IN), R1.1, R2.1, R3.1, R4.1

Notes on the sheet:
IMU board 'V6X IMU RC10'. All rails arrive over J1 from the FMUM. RM3100 = U3 MagI2C + L1/L2 Sen-XY-f + L3 Sen-Z-f with 121 R bias resistors and 33k REXT (PNI reference design).

Board: 4 copper layers, 37 parts (12 on the bottom side), 33 nets, no tracks yet.

Other parts of the board:
H1, H2: 2.2 mm; NPTH
M1, M2, M3, M4: GND pad; MPAD

Their connections:
GND: M1.1, M2.1, M3.1, M4.1; also elsewhere on the board
