eloyf26/PX4-Autopilot/(commit log)

2025-10-10 Point gazebo models to forked repo with custom camera config
    - Update submodule URL to eloyf26/PX4-gazebo-models
    - Track halcon1-stable branch with Halcon1-specific changes
    - Includes custom camera configuration for mission requirements
2026-01-04 fix: correct force arm logic to bypass preflight checks
    The force arm command (param2=21196) was not working for external
    commands because the logic `cmd.from_external || !forced` always
    evaluated to true when from_external=true.
    Changed to `!forced` so preflight checks are skipped when force
    arm is requested, regardless of whether the command is external.
2026-02-17 wip: disable GstCameraSystem, update gz models submodule
    - Comment out GstCameraSystem plugin in gz_bridge/server.config
    (conflicts with sim_cam_adapter streaming on same UDP port)
    - Update gz submodule with camera model and physics changes
    Core simulation streaming functional.
2026-06-16 chore: bump gz-models to legless x500 + body-centre model pose
    Repoints Tools/simulation/gz at PX4-gazebo-models@d87e371 (remove x500
    landing gear visual+collision, zero x500_base model <pose> so dynamic_pose/
    info reports base_link/body centre as ground truth). Supersedes the prior
    unpushed gz pin 42aaccca8b.
2026-06-16 feat: add aimbot HUD telemetry as a custom CRSF frame
    Re-pack the aimbot state (debug_vect, "AB"-tagged) into a custom 0x80 CRSF
    frame and emit it in the telemetry round-robin on both RC driver paths:
    crsf_rc (fmu-v6x) and rc_input/CRSFTelemetry (CUAV boards). Adds a host
    unit test asserting the 12-byte frame + CRC8 against the HUD decode contract.
2026-06-16 feat: bridge debug_vect over uXRCE-DDS for the aimbot down-link
    Subscribe /fmu/in/debug_vect so aimbot_node (Jetson) can publish the HUD
    state into PX4 for the CRSF telemetry encoder.
2026-09-10 fix(gz_bridge): synthesise the magnetometer instead of using Gazebo's
    Gazebo's magnetometer cannot be used as a heading reference, for two
    independent reasons.
    The bridge converted the frame with a determinant -1 reflection, a leftover
    workaround for a left-handed frame that gazebosim/gz-sim#2460 fixed. On
    gz-sensors 8.2.2 the result is not a rigid measurement of any field: rotated
    into the world frame with the true attitude it wanders 15.20 deg (median),
    55.86 deg (p95) instead of holding still. EKF2 rated the heading inconsistent
    for 57% of a flight and its in-flight realignment periodically snapped yaw onto
    it -- 64, 175 and 141 deg jumps in single 32 ms steps, each replacing an
    estimate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
    [GZBridge.cpp, GZBridge.hpp]
2026-09-10 fix(gz_x500): drop the datalink-loss action so headless runs can arm
    rcAndDataLinkCheck makes a GCS connection an arming requirement whenever
    NAV_DLL_ACT > 0, and headless simulation runs have no GCS. Arming then fails
    with "Preflight Fail: No connection to the GCS" in every mode, which showed up
    as the sim arming on some runs and not others depending on whether a GCS
    happened to be attached.
    halcon1-system has asked for this via PX4_PARAM_NAV_DLL_ACT=0 for a long time
    and it never took effect: rcS applies PX4_PARAM_* before the airframe script,
    and because 0 is the firmware default `param set` does not mark the parameter
    as modified, so the `param set-default` here silently won. It read 2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
2026-09-11 Add reverse-engineered schematic of the CUAV V6X FMUM module
    Identify the board from the photos (CUAV Pixhawk V6X FMU core module,
    silkscreen V6X_FMUM RC11, PX4 hardware type V6X001) and reconstruct its
    schematic from the fmu-v6x board files, the Pixhawk DS-010 Autopilot Bus
    and DS-012 FMUv6X standards.
    hardware/cuav_v6x_fmum/
    README.md identification, architecture, pin tables, BOM
    gen_schematic.py single data table -> 6 SVG sheets + netlist.csv
    build_html.py self-contained HTML report with the sheets inlined
    schematic/*.svg MCU, core peripherals, power+sensors, X1, X2, J3
    netlist.csv every U1/X1/X2/J3 pin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
    [netlist.csv]
2026-09-11 Add KiCad project and IMU board (V6X IMU RC10) to the CUAV V6X FMUM schematic
    - gen_kicad.py: generates a KiCad 8 project (kicad/) with five hierarchical
    sheets, embedded symbols and global-label connectivity from the same
    tables as the SVG sheets; validated with a KiCad s-expression parser
    (157 nets, no single-ended labels)
    - IMU board from the new photos: BMI088, ICM-42688-P, RM3100 (MagI2C +
    Sen-XY-f x2 + Sen-Z-f), ICP-20100 #1, 24LC64, 4x470R heater + MOSFET;
    new SVG sheet 07, KiCad sheet 05, netlist rows, README and HTML sections
    - README/HTML: state clearly that these are not vendor schematics
    Claude-Session: https://c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
    [01_mcu.kicad_sch, 02_bus_connectors.kicad_sch, 03_power_sensors.kicad_sch, 04_core.kicad_sch, 05_imu_board.kicad_sch, cuav_v6x_fmum.kicad_sch, netlist.csv]
2026-09-11 Add KiCad PCBs for both boards (FMU module and IMU board) with real footprints
    - parts.py: parts database with real package pin numbers from the datasheets
    (STM32H743IIKx ball map from ST open pin data, BMI088, ICM-20649,
    ICM-42688-P, ICP-20100, PNI MagI2C) and photo-derived placement
    - gen_kicad.py: two projects (kicad/fmum, kicad/imu) whose symbols use the
    real pin numbers so schematic and PCB round-trip
    - gen_pcb.py: generates cuav_v6x_fmum.kicad_pcb (36 x 31.4 mm, 6 layers,
    DS-010 outline/holes/connector positions, baro slot) and
    cuav_v6x_imu.kicad_pcb (octagon, 4 layers); official KiCad 8.0.8 library
    footprints embedded plus generated ones for DF40, BM20, BGA-176, PNI coils,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
    [01_imu.kicad_sch, 01_mcu.kicad_sch, 02_bus_connectors.kicad_sch, 02_connectors.kicad_sch, 03_power_sensors.kicad_sch, 04_core.kicad_sch, 05_imu_board.kicad_sch, cuav_v6x_fmum.kicad_pcb]
